huonghuy/High-Altitude-Monkey/SRC/Monkey/monkey code works version 1.11.txt

/////////// SOFTWARE VERSION NUMBER ///////////////////////////
// Ver 0.1M, 8/11/19
// Ver 0.2M, 8/14/19 adjusting communication from Serial2
// Ver 0.3MM  8/15/19 added Process_MONKEYMOVE
// Ver 0.4MM  8/16/19 got command parser to work from IDE
// Ver 0.5MM  8/19/19 ADDING HOME ROUTINE FOR SERVOS             
// Ver 0.6MM, 8/21/19 Intergrated serial communication between USIP and Monkey Board
// Ver 0.7MM, 8/22/19 Implemented monkey reply back top USIP board
// Ver 0.8MM, 8/23/19 Completed Monkey Touchdown move & monkey default position commands.
// Ver 0.9MM, 9/10/19 Works with Radio APRS
// Ver 0.91MM 9/26/19 Added monkey video commands
// Ver 0.92MM 9/26/19 Fixed string values for battey voltage, inside temp & xmtr temp, added IDE comm setup comments
// Ver 0.93MM 10/03/19 Added get_battery_voltage, get_inside_temp, get_tramsmitter_temp routines.
// Ver 0.94MM 10/03/19 Added sent get_battery_voltage, get_inside_temp, get_tramsmitter_temp to USIP board, and video on and off.
// Ver 0.95MM 10/07/19 I2C transmission to video.  Set I2CVIDEOADDR to the I2C address of the video
// Ver 0.96MM 10/13/19 Set voltage devide by value for battery.  
// Ver 0.97MM 10/13/19 Optimize Monkey Movements for Brown Monkey
// Ver 0.98MM 10/15/19 I2C works for Monkey and for potentiometer.
// Ver 0.99MM 10/15/19 Reads actual battery voltage, inside and Transmitter Temperature & MONKEY 17.
// Ver 1.0MM 10/17/19 Final chits-n-chatz before flight.
// Ver 1.1MM 10/17/19 Added stablize_monkey_slowly(); 
// Ver 1.11MM 10/18/19 Added slowed monkey even more.
//
// don't forget to adjust the #define VERSION below! 
// 
// USIP Copyright 2019 University of Bridgeport, Discovery Museum Bridgeport, CT, NASA, CT Space Grant Consortium.
// All rights reserved.
///////////////////////////////////////////////////////////////
#define VERSION "1.11MM" 

#include <Adafruit_DS3502.h>            // I2C digital potentiometer library
#include <Adafruit_PWMServoDriver.h>    //Download from Github
#include <Wire.h>                       //Included into Arduino library

// I2C section
#include <Adafruit_DS3502.h>            // I2C digital potentiometer library
Adafruit_DS3502 ds3502 = Adafruit_DS3502();
#define WIPER_pin A3

//Libraries Needed
//Adafruit busio

//Declarations
Adafruit_PWMServoDriver pwm = Adafruit_PWMServoDriver();

#define SERVOMIN 150 // min pulse lenghth count
#define SERVOMAX 600 // max pulse lenghth count

uint8_t servo1neck = 0;

int pos=0;
float fpos = 0.0;
int pos2=300;

int right=0;
int right2=300;
int right3=-60;

int left=0;
int left2=0;
int left3=0;

int ledpin = 13; // Led to blink
int x;
int MKRCV_pin = 16;
int MKXMT_pin = 17;

///////////////////// Tan Monkey Home Positions/////////////////////
int botHead0 = 300;
int topHead1 = 350;
int rightShoulder2 = 275;
int rightElbow3 = 400;
int leftShoulder4 = 400;
int leftElbow5 = 125;

int elbowRange = 50;

int xv;
float wiper_read = 0.0;
uint8_t wiper_value = 0;
int i=0;

///////////////////// New section///////////////////////////
String MonkeyCmd_str ="";   //will hold the command recieved from the USIP or IDE
String MONKEYMOVE_flg = ""; // what used for?
boolean MonkeyFlag= false; // when true used to call Monkey move routine in loop
boolean validcmd_flg = false;
String inStr0 ="";
String inStr2 ="";
boolean stablize_monkey_flg = false; // used to determine when to stabilize the monkey
unsigned long tee;

String Xavier="";
String Xavier2="";
String line="";

String thisStringIT = "";
String thisStringVB = "";;
String thisStringXT = "";

boolean string0Complete = false;  // whether the inStr0 is complete from the IDE Serial input routine
boolean string2Complete = false;  // whether the inStr0 is complete from the IDE Serial input routine
boolean I2Cpot = false;           // used at being of I2C return value to see if it began

#define MK1 "MONKEY"
#define MK01 "MONKEY 01"

int monkey_cmd_nbr = 0;  // used to parse monkey commands for video commands
int video_level = 0; // used to hold calculated video command number

// Battery Voltage defines
int Vbat = 0;    // battery voltage read
const float DivideByCircuit = 3.515; // divide by circuit factor this is the corrected value
int BatteryVoltagePin = A2; // Battery voltage connected to analog pin 2, outside leads to ground and +5V
int BatRead1  = 0;           // 1st value read of battery
float BatV1   = 0.0;         // variable to store the 1st value read
int BatRead2  = 0;           // 2nd value read of battery
float BatV2   = 0.0;         // variable to store the 1st value read
int BatRead3  = 0;           // 3rd value read of battery
float BatV3   = 0.0;         // variable to store the 1st value read
float BatSum  = 0.0;         // Battery Sum voltage used to calculate arithmetic mean
float BatMean = 0.0;         // arithmetic mean of battery voltage
int TenTimes  = 0;           // This is the voltage multiplied by 10 and then made into an integer.

// Inside Temperature defines
int InsideTempPin = A0; // Inside Temp sensor is connected to analog pin 0.
int InsideT = 0;   // Inside temp integer read
float TRaw = 0;    // raw temperature read
float TempK = 0.0; // is raw temperature converted to degrees Kelvin
float TempC = 0.0; //is Temperature Degrees Centigrade

// Transmitter Temperature defines
int XmtrTempPin = A1; // Inside Temp sensor is connected to analog pin A1.
int XmtrT = 0;   // transmitter temp Integer read
float XTRaw  = 0.0; //analogRead(XmtrTempPin);      // read transmitter temperature
float XTempK = 0.0; // = (XTRaw/2.046);
float XTempC = 0.0; // = XTempK - 273.15;
int xmtr_temp = 0; //  = (int) XTempC;

// Video Defines
// video ON/OFF is pin 22
#define VIDEO_pin 22  
#define I2CVIDEOADDR 51 // video device I2C address 50 hex write = 50, read = 51
int vid_status = 0;// this is the value returned by video_on() 1 = video is here, -1 = error.

////////////////////////////////////////////////////////////

void setup() {
  // setup code here, runs once:

  pinMode(ledpin, OUTPUT);
  pinMode(MKRCV_pin, INPUT);
  pinMode(MKXMT_pin, OUTPUT);
  pinMode(VIDEO_pin, OUTPUT); // video on off
  pinMode(WIPER_pin, INPUT); // wiper pin
  
  // initialize serial: 
  // Blink LED that we are up and running
  for (x=0; x<5; x++)  {
    digitalWrite(ledpin,HIGH);
    delay(100);
    digitalWrite(ledpin,LOW);
    delay(100);
  }
// IMPORTANT for IDE Communications, this configuration is important
// Autoscroll is checked
// Show Timestamp is unchecked
// first pull down is set to NEWLINE
// Baud pull down is set to whatever you set "Serial.begin" to in the statement below, in this case 9600
// Clear Output is not a settable button, It clears the output screen 
Serial.begin(9600);
Serial2.begin(9600);//Monkey cpu
//Serial.print("2 Channel servo test");
//Serial.println("");
Serial.print("USIP Monkey ");
Serial.println (VERSION); 
///////////////
//  Serial.println("Adafruit DS3502 Test");
//  Wire.begin();
//
//  if (!ds3502.begin(28)) {
//    Serial.println("Couldn't find DS3502 chip");
//    while (1);
//  }
//  Serial.println("Found DS3502 chip");
//  //////////
pwm.begin();
pwm.setPWMFreq(60);  //Analog servos run at ~60 Hz updates

// I2C bus set up
Wire.begin(); // join i2c bus (address optional for master)

I2Cpot = (ds3502.begin(0x28,&Wire));
  if (I2Cpot){
   Serial.println ("Found Pot");
 }
 else {
  Serial.print ("I couldn't find the I2C video pot! ");
  Serial.println ("MONKEY 17");
  Serial2.println("MONKEY 17");
 }

//monkey_rest(); // bring monkey to default positions AT THE START 
stablize_slowly();
} // end of setup

//////////////////////////////////////// LOOP /////////////////////////////////////////////////////
void loop() {      // Main code here, runs repeatedly

if (MonkeyFlag == true) {
  Process_MONKEYMOVE(MonkeyCmd_str);
  MonkeyCmd_str = ""; 
  MonkeyFlag = false;
}

//servohead_no_nod();
//servohead_yes_nod();
//servohead2(); //head half scan
//scanhead(); //Full scan
//right_arm2(); // Thumbs up
//left_arm (); // Wave
//monkey_chest();// Chest pound

/////not needed:////////
//head_scratch();
//monkey_reset();
//autopilot cycle();
} 

/////////////////////////////////////////////////////// Selecting a Monkey Command ////////////////////////////////////////////////////

void Process_MONKEYMOVE(String MonkCMDStr){
  validcmd_flg = false;
  stablize_monkey_flg = false;
    Serial.println(" ");
    Serial.print("ENTERED MONKEY MOVE/video set AND MonkCMDStr is: ");
    Serial.println(MonkCMDStr);

// Is it stablize?
if (MonkCMDStr.equals("MONKEY 00")){
    Serial.println("Command equals MONKEY 00 - Setting Monkey to default positions");
    // set any flags
    // call Monkey Motions
       stablize_slowly(); // bring monkey to default positions
  
    // send MONKEY 11 (done) to USIP
    Serial.print("MONKEY 11 (done) Signal");
    Serial2.println("MONKEY 11");
    validcmd_flg = true;
}
   
// Is it Head Nod Yes?
if (MonkCMDStr.equals("MONKEY 01")){
   Serial.println("Command equals MONKEY 01");
    // set any flags
    // call Head Nod Yes
   servohead_yes_nod();
    Serial.println("RETURNED FROM yes_nod()MONKEY01");    
    monkey_rest(); // bring monkey to default positions
    
    // send MONKEY 11 (done) to USIP 
    Serial.print("MONKEY 11 (done) Signal");
    Serial2.println("MONKEY 11");
    stablize_monkey_flg = true;
    validcmd_flg = true;
}

// Is it Head Nod No?
if (MonkCMDStr.equals("MONKEY 02")){
   Serial.println("Command equals MONKEY 02");
    // set any flags
    // call Head Nod No
  //    servohead_no_nod();
 servohead_no_nod();
 Serial.println("RETURNED FROM no_nod()MONKEY02");   
    
 monkey_rest(); // bring monkey to default positions

 // send MONKEY 11 (done) to USIP 
    Serial.print("MONKEY 11 (done) Signal");
    Serial2.println("MONKEY 11");
      validcmd_flg = true;
      stablize_monkey_flg = true;
}

// Is it Right Arm Thumbs Up?
if (MonkCMDStr.equals("MONKEY 03")){
    Serial.println("Command equals MONKEY 03");
    // set any flags
    // call Right Arm Thumbs Up
    right_arm2();
 Serial.println("RETURNED FROM right_arm2()MONKEY03"); 
    
    // send MONKEY 11 (done) to USIP 
      //monkey_rest();zzzz // bring monkey to default positions 
    Serial.print("MONKEY 11 (done) Signal");
    Serial2.println("MONKEY 11");
    validcmd_flg = true;
      stablize_monkey_flg = true;
}

// Is it Scan Head?
if (MonkCMDStr.equals("MONKEY 04")){
    Serial.println("Command equals MONKEY 04");
    // set any flags
    // call Scan Head
    scanhead();
     Serial.println("RETURNED FROM scan_head()MONKEY04"); 
    // send MONKEY 11 (done) to USIP
      monkey_rest(); // bring monkey to default positions
    Serial.print("MONKEY 11 (done) Signal");
  Serial2.println("MONKEY 11");
    validcmd_flg = true;
      stablize_monkey_flg = true;
}
// Is it Left Hand Wave?
if (MonkCMDStr.equals("MONKEY 05")){
    Serial.println("RETURNED FROM left_hand_wave()MONKEY05"); 
    // set any flags
    // call Left Hand Wave
    left_arm ();
    // send MONKEY 11 (done) to USIP
      monkey_rest(); // bring monkey to default positions
    Serial.print("MONKEY 11 (done) Signal");
    Serial2.println("MONKEY 11");
    validcmd_flg = true;
      stablize_monkey_flg = true;
}
// Is it a chest pound?
if (MonkCMDStr.equals("MONKEY 06")){
    Serial.println("RETURNED FROM chest_pound()MONKEY06"); 
    // set any flags
    // call Chest Pound
    monkey_chest();
    // send MONKEY 11 (done) to USIP
      //monkey_rest(); // bring monkey to default positions
      monkey_rest(); // bring monkey to default positions
    Serial.print("MONKEY 11 (done) Signal");
   Serial2.println("MONKEY 11");
   validcmd_flg = true;
     stablize_monkey_flg = true;
}
// Is it a touchdown signal?
if (MonkCMDStr.equals("MONKEY 07")){
    Serial.println("Command equals MONKEY 07");
    // set any flags
     monkey_touchdown(); // monkey to raise both arms up at once
     Serial.println("MONKEY 07 (touchdown) Signal");
     Serial2.println("MONKEY 11");
      //monkey_rest(); // bring monkey to default positions
      //monkey_rest(); // bring monkey to default positions
 //stablize_slowly(); // test
//    Serial.print("MONKEY 11 (done) Signal");
//    Serial2.println("MONKEY 11");
    validcmd_flg = true;
      stablize_monkey_flg = true;
}
// Is it all motions executed once?
if (MonkCMDStr.equals("MONKEY 08")){
    Serial.println("Command equals MONKEY 08");
    // set any flags
    // call Monkey Motions
      servohead_no_nod();
       servohead_yes_nod();
       scanhead(); //Full scan
       right_arm2(); // Thumbs up right arm
       left_arm (); // Wave left arm
       monkey_chest();  // Chest pound

       //monkey_rest(); // bring monkey to default positions
    // send MONKEY 11 (done) to USIP
    monkey_rest(); // bring monkey to default positions
    Serial.print("MONKEY 11 (done) Signal");
    Serial2.println("MONKEY 11");
    validcmd_flg = true;
      stablize_monkey_flg = true;
}
//I am Here
if (MonkCMDStr.equals("MONKEY 09")){
    Serial.println("Command equals MONKEY 09");
    Serial2.println("MONKEY 10");
        Serial.println("Sent MONKEY 10");
    validcmd_flg = true;
      stablize_monkey_flg = false;
}
// Is it a REQUEST FOR DATA?
if (MonkCMDStr.equals("MONKEY 12")){
    Serial.println("Command equals MONKEY 12");
    // Read appropriate Data
    // write data into appropriate variables
    // Vbat = battery voltage Integer
    // InsideT = Inside temp integer
    // XmtrT = transmitter temp Integer

      Vbat = get_bat_voltage(); // this routine reads the battery voltage
          Serial.println("battery voltage read");
          Serial.println(Vbat);
      InsideT = get_inside_temp(); // this routine reads the inside temperature
          Serial.println("Inside temperature read");
            Serial.println(InsideT);        
      XmtrT = get_xmtr_temp();   // this routine reads the transmitter temperature
          Serial.println("transmitter temperature read");
           Serial.println(XmtrT);     
//
//    tee = millis();
//Serial.print ("end time = ");
//Serial.println (tee);

    // send back MONKEY 13    
    // send data to USIP board via Serial 2
            Serial2.print("MONKEY 13 ");
    // send back Vbat InsideT and XmtrT
            Serial2.print(Vbat);
            Serial2.print(",");
            Serial2.print(InsideT);
            Serial2.print(",");
            Serial2.println(XmtrT);   
          // send monkey done
          // send MONKEY 11 (done) to USIP
          // Serial.print("MONKEY 11 (done) Signal");
         //  Serial2.println("MONKEY 11");
  
    validcmd_flg = true;
      stablize_monkey_flg = false;
}

// Is it a turn video OFF command?
if (MonkCMDStr.equals("MONKEY 20")){
    Serial.println("Command equals MONKEY 20");
    // set any flags
     Serial.println("MONKEY 20 turn video OFF");
    video_off(); // turn off video
    Serial.print("MONKEY 11 (done) Signal");
    Serial2.println("MONKEY 11");
    validcmd_flg = true;
}

// Is it a turn video ON command?
if (MonkCMDStr.equals("MONKEY 19")){
    Serial.println("Command equals MONKEY 19");
    // set any flags
     Serial.println("MONKEY 19 turn video ON");
     
    vid_status = video_on(); // turn on video  
    switch (vid_status) {
      case -1:
        // report to USIP that video is ON
            Serial.print("MONKEY 11 (done) Signal");
            Serial2.println("MONKEY 11");
         break;
      case 1:
        // report to USIP that video is NOT WORKING
        break;
      default:
        // report to USIP that video has returned a strange number
        break;
}
      
    vid_status = 0;// set to zero for next time
    validcmd_flg = true;
}

//check for a valid monkey video command 
// MonkCMDStr
monkey_cmd_nbr = MonkCMDStr.substring(7,9).toInt(); // monkey command now an interger number from 21 to 84

if ((monkey_cmd_nbr >= 21) && (monkey_cmd_nbr <= 84)){
// calculate the video level from monkey_cmd_nbr 
    Serial.println("calculating monkey video level number");
    video_level = (2*(monkey_cmd_nbr - 21));
    Serial.println("setting monkey video level number to:");
    Serial.println(video_level);
         
    set_video_level(video_level);
 
    Serial.print("set monkey video (done)");
    Serial.print("MONKEY 11 (done) Signal");
    Serial2.println("MONKEY 11");
    
    validcmd_flg = true; 
}  // end of if

/////////////////////////////////////////////////////////////////////// 
// etc do all the valid monkey xx commands
// then do invalid command
// is it invalid command?
//if (validcmd_flg==false && MonkCMDStr.equals("MONKEY 01") ){
 //  Serial.println("Invalid MONKEY ");

if( validcmd_flg == false){
 Serial.println("Invalid MONKEY Sent Dumped Command");
 Serial2.println("MONKEY 14"); //Dumped Command
 // dump the command it's no good
// send MONKEY 14 to USIP  I dumped it.
// transmit dump command
}

// No matter what, clear the MONKEYMOVE flag and all the rest of the flags etc.
MONKEYMOVE_flg = "";
MonkeyFlag= false;
MonkeyCmd_str = ""; 
monkey_cmd_nbr = 0; 
if (stablize_monkey_flg == true){
stablize_slowly();
}
stablize_monkey_flg = false; 
}

/////////////////////////////////////////////////////////////////////////////////////////////////////////////////////////////////////////////

/////////////Monkey Commands//////////////////

///////////////////////////////////////////was 10 10////3////////////////////////////////
void stablize(){
 Serial.println("Stablizing Monkey");
  for(pos = rightShoulder2; pos <= rightShoulder2 + 15; pos += 1){
    pwm.setPWM(2,0,pos);
    delay(3);
    pwm.setPWM(3,0,pos + 125);
    delay(3);
    pwm.setPWM(4,0,pos + 125);
    delay(3);
    pwm.setPWM(5,0,pos - 150);
    delay(3);
  }
  for(pos = rightShoulder2 + 15; pos >= rightShoulder2; pos -= 1){
    pwm.setPWM(2,0,pos);
    delay(3);
    pwm.setPWM(3,0,pos + 125);
    delay(3);
    pwm.setPWM(4,0,pos + 125);
    delay(3);
    pwm.setPWM(5,0,pos - 150);
    delay(3);
  }
  
}
///////////////////////////////////////////was 10 10////3////////////////////////////////
void stablize_slowly(){
 Serial.println("Slowly Stablizing Monkey");
  for(pos = rightShoulder2; pos <= rightShoulder2 + 15; pos += 1){
    pwm.setPWM(2,10,pos);
    delay(15);
    pwm.setPWM(3,10,pos + 125);
    delay(15);
    pwm.setPWM(4,10,pos + 125);
    delay(15);
    pwm.setPWM(5,10,pos - 150);
    delay(15);
  }
  for(pos = rightShoulder2 + 15; pos >= rightShoulder2; pos -= 1){
    pwm.setPWM(2,10,pos);
    delay(15);
    pwm.setPWM(3,10,pos + 125);
    delay(15);
    pwm.setPWM(4,10,pos + 125);
    delay(15);
    pwm.setPWM(5,10,pos - 150);
    delay(15);
  }
  servohead_no_nod_slowly();
}

/////////////////////////////////////////////////////////////

void servohead_yes_nod() {
//Servo1 left and right motion
Serial.println("Entered servohead_yes_nod()MONKEY 01");
for (pos = topHead1; pos <= topHead1 + 150; pos += 2) { // goes from 0 degrees to 180 degrees
  //Range = 150
    // in steps of 1 degree

    pwm.setPWM(0,0,botHead0); //start bottom servo head at middle position
    delay(2);

    pwm.setPWM(1,0,pos); //move top servo head down in increments
    delay(5);

 }

//for (pos = 400; pos >= 300; pos -= 1) { 
  for (pos = topHead1 + 150; pos >= topHead1; pos -= 1) {

      pwm.setPWM(1,0,pos); //move top servo head up in increments
      delay(5);
  
  }// 1st round

//2nd round:

//for (pos = 300; pos <= 400; pos += 1) { // goes from 0 degrees to 180 degrees
//    // in steps of 1 degree
//
//    pwm.setPWM(0,0,300); //start bottom servo head at middle position
//    //pos2=SERVOMIN;
//    delay(2);
//   
//    pwm.setPWM(1,0,pos-150); //move top servo head down in increments
//      delay(2);
//
//  }
//
//for (pos = 400; pos >= 300; pos -= 1) { 
//
//
//      pwm.setPWM(1,0,pos-150); //move top servo head up in increments
//      delay(2);
//  
//}

} //end servohead_yes_nod

//////////////////////////////////////////////////////////////////////////////////////////////////////////

void servohead_no_nod() {
//Servo1 left and right motion
for (pos = botHead0; pos <= botHead0 + 90; pos += 1) { // goes from 0 degrees to 180 degrees
   //Range = 90
 pwm.setPWM(0,0,pos); //bottom servo head    
    delay(2);    
 pwm.setPWM(1,0,topHead1); //top servo head
      delay(5);
  }

for (pos = botHead0 + 90; pos >= botHead0 - 90; pos -= 1) { 
  pwm.setPWM(0,0,pos);
  delay(2); 
}  //1st round

//2nd round:

for (pos = botHead0 - 90; pos <= botHead0; pos += 1) { // goes from 0 degrees to 180 degrees  
 pwm.setPWM(0,0,pos); //bottom servo head
    //pos2=SERVOMIN;
    delay(2);
    pwm.setPWM(1,0,topHead1); //top servo head
      delay(5);
  }

for (pos = botHead0; pos <= botHead0 + 90; pos += 1) { // goes from 0 degrees to 180 degrees
   //Range = 90
 pwm.setPWM(0,0,pos); //bottom servo head
   delay(2);   
 pwm.setPWM(1,0,topHead1); //top servo head
      delay(5);
  }
for (pos = botHead0 + 90; pos >= botHead0 - 90; pos -= 1) { 
  pwm.setPWM(0,0,pos);
  delay(2);
}  //1st round

//2nd round:
for (pos = botHead0 - 90; pos <= botHead0; pos += 1) { // goes from 0 degrees to 180 degrees   
 pwm.setPWM(0,0,pos); //bottom servo head
    //pos2=SERVOMIN;
    delay(2);
    pwm.setPWM(1,0,topHead1); //top servo head
      delay(5);
  }
}//end of no nod

//////////////////////////////////////////////////////////////////////////////////////////////////////////

void left_arm (){
 
  for (left = leftShoulder4; left >= leftShoulder4 - 250; left -= 1) { // 1ft move up shoulder
    //Range == -250
   //if(left>100){
   pwm.setPWM(4,0,left);
   //pos2=300;
   delay(7);
   }

//hand wave 1st cycle:

for (left = leftElbow5; left <= leftElbow5 + elbowRange; left += 1) { // 2nd move right side arm 2 of 2
  //Range == +60
   //if(left>100){
   pwm.setPWM(5,0,left);
   //pos2=300;
   delay(5);
   }
for (left = leftElbow5 + elbowRange; left >= leftElbow5; left -= 1) { // 2nd move left side arm  1 of 2
   //if(left>100){
   pwm.setPWM(5,0,left);
   //pos2=300;
   delay(5);
   }

//hand wave 2nd cycle

/////////////////////// hand wave 1st cycle//////////////////////////////////////////////
for (left = leftElbow5; left <= leftElbow5 + elbowRange; left += 1) { // 2nd move right side arm 2 of 2
  //Range == +60
   //if(left>100){
   pwm.setPWM(5,0,left);
   //pos2=300;
   delay(5);
   }
for (left = leftElbow5 + elbowRange; left >= leftElbow5; left -= 1) { // 2nd move left side arm  1 of 2
   //if(left>100){
   pwm.setPWM(5,0,left);
   //pos2=300;
   delay(5);
   }

////////////////////////////////////

//////////Returning shoulder back to original position///////////////////////

  for (left = leftShoulder4 - 250; left <= leftShoulder4; left += 1) { // 3rd move down slowly shoulder
   //if(left>100){
   pwm.setPWM(4,0,left);
   //pos2=300;
   delay(7);
   }

}//end of left arm

/////////////////////////////////////////////////////////////////////////////////////////////////////////////

void servohead2(){      //Tilt,look down and reset
//Servo1 left and right motion
for (pos = botHead0; pos <= botHead0 + 100; pos += 1) { // goes from 0 degrees to 180 degrees
  //Range == +100
    // in steps of 1 degree

    pwm.setPWM(0,0,pos); //bottom servo head
    //pos2=SERVOMIN;
    delay(5);

    pwm.setPWM(1,0,pos-150); //top servo head RH
      delay(5);

  }

for (pos = botHead0 + 100; pos >= botHead0; pos -= 1) { 

  pwm.setPWM(0,0,pos);
  delay(15);

      pwm.setPWM(1,0,pos-150); //top servo head
      delay(5);
  
}

}//end of servohead2 

////////////////////////////////////////////////////////
void scanhead(){       //ACtually scanning the console
//Servo1 left and right motion
for (pos = botHead0; pos <= botHead0 + 100; pos += 1) { // goes from 0 degrees to 180 degrees
  //Range = +100
    // in steps of 1 degree
    // Head tilts down as it turns left

    pwm.setPWM(0,0,pos); //bottom servo head
    //pos2=SERVOMIN;
    delay(5);

    pwm.setPWM(1,0,pos+50); //top servo head
      delay(5);

  }

for (pos = botHead0 + 100; pos >= botHead0 - 100; pos -= 1) { 
  // Head locks angle of neck and looks right
  pwm.setPWM(0,0,pos);
  delay(3);

      //pwm.setPWM(1,0,pos-150); //top servo head
      //delay(5);
  
}
for (pos = botHead0 - 100; pos <= botHead0 + 100; pos += 1) { 
  // Head looks back left
  pwm.setPWM(0,0,pos);
  delay(3);

      //pwm.setPWM(1,0,pos-150); //top servo head
      //delay(5);
  
}
for (pos = botHead0 + 100; pos >= botHead0; pos -= 1) { 
  // Head returns to normal
  pwm.setPWM(0,0,pos);
  delay(3);

      pwm.setPWM(1,0,pos+50); //top servo head
      delay(5);
  
}

}///////////////////end of scan head

void right_arm2 (){   //Thumbs up action
  for (right = rightShoulder2; right <= rightShoulder2 + 200 ; right += 1) { // goes from 0 degrees to 180 degrees
    //Range = + 200
    pwm.setPWM(2,0,right); //right shoulder servo head
    delay(5);
    
  }

  for (right = rightElbow3; right >= rightElbow3 - 95; right -= 1) {
    //Range = -95
      pwm.setPWM(3,0,right); //right arm servo head
      delay(10); 
  }
  
  for (right = rightElbow3 - 95; right <= rightElbow3; right += 1) {
      pwm.setPWM(3,0,right); //right arm servo head
      delay(7); 
  }

  for (right = rightShoulder2 + 200; right >= rightShoulder2; right -= 1) { // goes from 180 degrees to 0 degrees
  
   pwm.setPWM(2,0,right);
   //pos2=300;
   delay(5);
   }

} //end right_arm

////////////////////////////////////////////////////////////////////////////////////////

void monkey_chest (){   //Monkey beating chest action
//Range = +170
  for (right = rightShoulder2; right <= rightShoulder2 + 170; right += 1) { // move up right shoulder
    pwm.setPWM(2,0,right); //right shoulder servo head
    delay(5);
    
  }

  ///>>>>>>>>>Right arm Movement>>>>>////////

for (left = leftShoulder4; left >= leftShoulder4 - 200; left -= 1) { // 1ft move up left shoulder
  //Range = -200
   //if(left>100){
   pwm.setPWM(4,0,left);
   //pos2=300;
   delay(7);
   }
///////////////////////////////// 

//Right forearm motion: 1st cycle

  for (right = rightElbow3; right >= rightElbow3 - 225; right -= 1) {
    //Range = - 225
      pwm.setPWM(3,0,right); //right arm servo head
      delay(1); 
  }
 
  for (right = rightElbow3 - 225; right <= rightElbow3; right += 1) {
      pwm.setPWM(3,0,right); //right arm servo head
      delay(1); 
 }

// left forearm motion: 1st cycle

for (left = leftElbow5; left <= leftElbow5 + 200; left += 1) { // 2nd move right side arm 2 of 2
  //Range = +200
   //if(left>100){
   pwm.setPWM(5,0,left);
   //pos2=300;
   delay(1);
   }
for (left = leftElbow5 + 200 ; left >= leftElbow5; left -= 1) { // 2nd move left side arm  1 of 2
   //if(left>100){
   pwm.setPWM(5,0,left);
   //pos2=300;
   delay(1);
   }

/////////////////////////////////////////////
//////// 2nd cycle of forearm chest movement

//Right forearm motion: 2nd motion

  for (right = rightElbow3; right >= rightElbow3 - 225; right -= 1) {
    //Range = - 225
      pwm.setPWM(3,0,right); //right arm servo head
      delay(1); 
  }
 
  for (right = rightElbow3 - 225; right <= rightElbow3; right += 1) {
      pwm.setPWM(3,0,right); //right arm servo head
      delay(1); 
 }

// left forearm motion: 2nd motion

for (left = leftElbow5; left <= leftElbow5 + 200; left += 1) { // 2nd move right side arm 2 of 2
  //Range = 200
   //if(left>100){
   pwm.setPWM(5,0,left);
   //pos2=300;
   delay(1);
   }
for (left = leftElbow5 + 200 ; left >= leftElbow5; left -= 1) { // 2nd move left side arm  1 of 2
   //if(left>100){
   pwm.setPWM(5,0,left);
   //pos2=300;
   delay(1);
   }

////////

  for (right = rightShoulder2 + 170; right >= rightShoulder2; right -= 1) { // bring left shoulder back to original position
  
   pwm.setPWM(2,0,right);
   //pos2=300;
   delay(5);
   }

for (left = leftShoulder4 - 200; left <= leftShoulder4; left += 1) { // bring left shoulder back to original position
   pwm.setPWM(4,0,left);
   delay(3);
   }

} //end chest movement

///////////////////////////////////////////////////////////////////////

//Communication section - taking in initial commands

// --> one from keyboard (IDE - Serial.print() )
/* SerialEvent occurs whenever a new data comes in the
   hardware serial RX.  This routine is run between each
   time loop() runs, so using delay inside loop can delay
   response.  Multiple bytes of data may be available.
*/
void serialEvent() {
   while (Serial.available()) {
                 // get the new byte:
                 
// Serial.print("GETTING NEW BYTE\n");  

                 char inChar0 = (char)Serial.read();
                 // add it to the inputString:
                 
                   Serial.print("Just read character: ");
                    Serial.print(inChar0,HEX);
                      Serial.print(" ");
                    Serial.print(inChar0);
                   Serial.println();
                   
                 inStr0 += inChar0;
                 //Serial.print("Test String : ");
                  Serial.println(inStr0);
                  
                  if (inStr0.length() > 11) {
                    inStr0 = "";
                  }
                  
                 // if the incoming character is a newline, set a flag
                 // so the main loop can do something about it:
                 if (inChar0 == '\n') {
                    string0Complete = true;

                    ////
                    Serial.println("Temp String is: " + inStr0);
                    Serial.print("It is this many characters long: ");
                    Serial.println(inStr0.length());

                    Xavier = inStr0.substring(0,9);

                    Serial.println("The substring is: " + Xavier);

                 //   line = "\n";
                //    Xavier.concat(line);

                    MonkeyCmd_str = Xavier;

                //    Serial.print( MonkeyCmd_str,HEX);

                 //   MonkeyCmd_str = inStr0; // store completed string0 into monkey Command string
                    
                    ////troubleshooting//////////
                    Serial.print(MonkeyCmd_str);
                    
                    ////////////////
                    
                    inStr0 = "";
                    MonkeyFlag= true; // Signal loop that we are ready to process monkey command
                    Serial.println("set MonkeyFlag = True");
                 }
               }
/*//// TESTING////////////////////////////////////////////////////////////
//// TESTING////////////////////////////////////////////////////////////
//// TESTING////////////////////////////////////////////////////////////
/////////////////////////////////////
          if (MonkeyFlag == true) {
            Serial.println("MonkeyFlag is True");
            }  
          else{
            Serial.println("MonkeyFlag is not True");
            } 

          ///////////////////////*/
       //    MonkeyFlag= true;
       //   MonkeyCmd_str = "MONKEY 12";   
//// TESTING////////////////////////////////////////////////////////////           

          }// end of serialEvent() // must leave this line after testing
//////////////////////////////////////////////////////////////////////////////////////////////
void serialEvent2() {
   while (Serial2.available()) {
                 // get the new byte:
                 
// Serial.print("GETTING NEW BYTE\n");  

                 char inChar2 = (char)Serial2.read();
                 // add it to the inputString:
                 
                   Serial.print("Just read character: ");
                    Serial.print(inChar2,HEX);
                      Serial.print(" ");
                    Serial.print(inChar2);
                   Serial.println();
                   
                 inStr2 += inChar2;
                 
                  if (inStr2.length() > 11) {
                    inStr2 = "";
                  }
                 // if the incoming character is a newline, set a flag
                 // so the main loop can do something about it:
                 if (inChar2 == '\n') {
                    string2Complete = true;

                    ////
                    Serial.println("Temp String is: " + inStr2);
                    Serial.print("It is this many characters long: ");
                    Serial.println(inStr2.length());

                    Xavier2 = inStr2.substring(0,9);

                    Serial.println("The substring is: " + Xavier2);

                 //   line = "\n";
                //    Xavier.concat(line);

                    MonkeyCmd_str = Xavier2;

                //    Serial.print( MonkeyCmd_str,HEX);

                 //   MonkeyCmd_str = inStr0; // store completed string0 into monkey Command string
                    
                    ////troubleshooting//////////
                    Serial.print(MonkeyCmd_str);
                    
                    ////////////////
                    
                    inStr2 = "";
                    MonkeyFlag= true; // Signal loop that we are ready to process monkey command
                 }
               }

             }

//////////////////////////////////////////////////////////////////////////
// Head Servo Left & Right
void bottom_head_servo_go_home(){  //pin 0 - on servo board                  
Serial.println("Entered bottom_head_servo_go_home(): Moving top servo to home ");
   pwm.setPWM(0,0,300); // 300 is facing forward. Greater moves right, less moves left
  
}
/////////////////////////////////////////////////////////////////////////////////
// Head Servo Up & Down
void top_head_servo_go_home(){  //pin 1 - on servo board
Serial.println("Entered top_head_servo_go_home(): Moving bottom servo to home ");
   pwm.setPWM(1,0,220);  // greater is up, less is down
   
}

/////////////////////////////////////////////////////////////////////////////////
// Brings Right shoulder down
void right_shoulder_go_home(){  //pin 2 - on servo board 
Serial.println("Entered right_shoulder_go_home() ");
 pwm.setPWM(2,0,275); // greater is up, less is down

}

/////////////////////////////////////////////////////////////////////////////////
// brings right elbow outwards
void right_elbow_go_home(){  //pin 3 - on servo board 
  Serial.println("Entered right_elbow_go_home() ");
   pwm.setPWM(3,0,200); // less is inward
   
}

/////////////////////////////////////////////////////////////////////////////////
// Brings Left shoulder down
void left_shoulder_go_home(){  //pin 4 - on servo board 
  pwm.setPWM(4,0,400); // less is up, greater is down
  
Serial.println("Entered left_shoulder_go_home() ");
}

/////////////////////////////////////////////////////////////////////////////////
// brings left elbow outwards
void left_elbow_go_home(){  //pin 5 - on servo board 
  Serial.println("Entered left_elbow_go_home() ");
 pwm.setPWM(5,0,leftElbow5); // greater is outwards
 
}

/////////////////////////////////////////////////////////////////////////////////
// Monkey Touchdown
void monkey_touchdown(){  //pin 5 - on servo board 
  Serial.println("Entered monkey touch down() ");

  touchdown_head_bottom_servo_();
  touchdown_head_top_servo_();
  touchdown_right_elbow_go_home();
  left_elbow_go_home(); 
  touchdown_left_arm_go_up();  
  right_arm_go_up();
  stablize_slowly();

  }
  /////////////////////////////////////////////////////////////////////////////////
// MONKEY LEFT ARM GO UP
// assumes left elbow in home position
void left_arm_go_up(){  
    for (left = leftShoulder4; left >= leftShoulder4 - 400; left -= 1) { // 1ft move up shoulder
      //Range = -400
   //if(left>100){
   pwm.setPWM(4,0,left);
   //pos2=300;
   delay(7);
   }
  Serial.println("Entered monkey left arm go up() ");

  }

  ///////////////////////////////////////////////////////////////////////////////////
  void touchdown_left_arm_go_up(){  
    for (left = leftShoulder4; left >= leftShoulder4 - 300; left -= 1) { // 1ft move up shoulder  
      //Range = -300
   //if(left>100){
   pwm.setPWM(4,0,left);
   //pos2=300;
   delay(7);
   }
  Serial.println("Entered monkey touchdown left arm go up() ");

  }
  /////////////////////////////////////////////////////////////////////////////////
// MONKEY RIGHT ARM GO UP
// assumes right elbow in home position
void right_arm_go_up(){  
  Serial.println("Entered monkey right arm go up() ");
  
  for (right = rightShoulder2; right <= rightShoulder2 + 710; right += 1) { // move up right shoulder  //690
    //Range = + 710
    pwm.setPWM(2,0,right); //right shoulder servo head
    
    delay(5);
    
  }
  }
/////////////////////////////////////////////////////////////////////////////////
// brings right elbow outwards for touchdown
void touchdown_right_elbow_go_home(){  //pin 3 - on servo board 
   Serial.println("Entered touchdown_right_elbow_go_home() ");
   pwm.setPWM(3,0,rightElbow3); // 390-400 LOOKS GOOD
}

//////////////////////////////////////////////////////////////////////////////////////
void touchdown_head_bottom_servo_(){ //MOVES HEAD TO THE MIDDLE POSITION (HORIZONTALLY)
  Serial.println("Entered touchdown_head_bottom_servo_() ");
  pwm.setPWM(0,0,botHead0); // 390-400 LOOKS GOOD
  
}
////////////////////////////////////////////////////////////////////////////////////////

//////////////////////////////////////////////////////////////////////////////////////
void touchdown_head_top_servo_(){   ////MOVES HEAD DOWN A LITTLE (VERTICALLY)
  Serial.println("Entered touchdown_head_top_servo_() ");
   pwm.setPWM(1,0,topHead1); // 390-400 LOOKS GOOD
  
}
////////////////////////////////////////////////////////////////////////////////////////

void monkey_rest(){     // Runs when "Monkey 00" comand is called
    // call Monkey Motions
//  bottom_head_servo_go_home();
//  top_head_servo_go_home();  
//  right_shoulder_go_home();
//  left_shoulder_go_home(); 
//  left_elbow_go_home();
//  right_elbow_go_home(); 
//  
}

///////////////////////////////////////////////////////////////////////////////////////
//this issues the command to turn the video OFF

void video_off(){
  Serial.println("Entered video_off()");
      digitalWrite(VIDEO_pin, LOW);
}

///////////////////////////////////////////////////////////////////////////////////////
//this issues the command to turn the video ON
// This should then test to see if the video is operating
// if yes then set the level to 
// if no, then report that the video is "not on"
// make this a function which returns 1 = good, -1 = bad not turned on

int video_on(){
  int video_status;
    Serial.println("Entered video_on()");
    digitalWrite(VIDEO_pin, HIGH);
    set_video_level(31);  // set video to mid level of 31
    delay (100);
    // query the video R U there?

return (video_status);
}

///////////////// Set Video Level ////////////////////////////////////////////////
//I2CVIDEOADDR  IS #def'd at top and is the video device I2C address
//
void set_video_level(int video_level){
  
      Serial.println("Entered set_video_level()");
      //Wire.write(video_level);
      ds3502.setWiper(video_level); 

      //read the pin 
      wiper_read = analogRead(WIPER_pin);
      Serial.print ("wiper read value from pin =  ");
      Serial.println (wiper_read);
      
      Serial.println("Reading the wiper");
      wiper_value = ds3502.getWiper();
      Serial.print ("wiper read value from get.Wiper() =  ");
      Serial.println (wiper_value);
 
/* test software

 for (i=21; i<84; i++){
 video_level = i;
      //Wire.write(video_level);
 ds3502.setWiper(i); 
 wiper_read = analogRead(WIPER_pin);
 Serial.print ("i =  ");
 Serial.print (i);
 Serial.print (" wiper read value from pin =  ");
 Serial.print (wiper_read);
 Serial.print("  ");     
 Serial.print("Reading the wiper"); 
 wiper_value = ds3502.getWiper();
 Serial.print ("wiper read value from get.Wiper() =  ");
 Serial.println (wiper_value);
 }
 */
      
}

/////////////////////////////// this routine reads the battery voltage ///////////////////////////////////////////////////
int get_bat_voltage(){
// battery voltage
// voltage = 0.0 - 5.0v
// ADC = 0.0 - 1023
// Battery voltage range is 0.0 - 16.8 volts
// There will be a divide by 4 circuit between the pin and the sensor
// Actual battery voltage = (calculated voltage read) * (Divide by circuit = 4) 
//       y      =  m       *  X            + b
// voltage read = (5/1023) * (ADC reading) + 0
// Take 3 readings 1/10 second apart.
// convert the readings to voltage
// convert the voltages to battery voltages via DivideByCircuit factor
// sum the voltages then take arithmetic mean by dividing by 3
// multiply by 10 as we are sending the voltage and the first decimal digit
// then convert to integer and send the integer of 10 times the voltage
// Battery Voltage defines
// int Vbat = 0;    // battery voltage read
// const float DivideByCircuit = 3.6; // divide by circuit factor
// int BatteryVoltagePin = A2;  // Battery voltage connected to analog pin 2, outside leads to ground and +5V
// int BatRead1  = 0;           // 1st value read of battery
// float BatV1   = 0.0;         // variable to store the 1st value read
// int BatRead2  = 0;           // 2nd value read of battery
// float BatV2   = 0.0;         // variable to store the 1st value read
// int BatRead3  = 0;           // 3rd value read of battery
// float BatV3   = 0.0;         // variable to store the 1st value read
// float BatSum  = 0.0;         // Battery Sum voltage used to calculate arithmetic mean
// float BatMean = 0.0;         // arithmetic mean of battery voltage
// int TenTimes  = 0;           // This is the voltage multiplied by 10 and then made into an integer.
//
//tee = millis();
//Serial.print ("time before read = ");
//Serial.println (tee);

BatRead1 = analogRead(BatteryVoltagePin);  // read the input pin for the first time
delay(100); // delay 0.1 seconds

BatRead2 = analogRead(BatteryVoltagePin);  // read the input pin for the 2nd time
delay(100); // delay 0.1 seconds

BatRead3 = analogRead(BatteryVoltagePin);  // read the input pin for the 3rd time
//Serial.println(BatRead1);
//Serial.println(BatRead2);
//Serial.println(BatRead3);

// calculate the voltages from the ADC  read values
BatV1 = (((float)BatRead1)/204.6) * DivideByCircuit;

BatV2 = (((float)BatRead2)/204.6) * DivideByCircuit;

BatV3 = (((float)BatRead3)/204.6) * DivideByCircuit;
//Serial.println(BatV1);
//Serial.println(BatV2);
//Serial.println(BatV3);
BatSum = BatV1+BatV2+BatV3;
BatMean = (BatSum/3.0);
TenTimes = (int)(BatMean * 10.0);

return (TenTimes);

}

//////////////////////////////////////////////////////////////////////////////
//////////////////////////// this routine reads the inside temperature //////////////////////////////////////////////////////
// Read appropriate Data
// Inside Temp is read on pin A0
// voltage = 0.0 - 5.0v
// ADC = 0.0 - 1023
// Temperature is 0 - 500 K (degrees Kelvin)
// We should send USIP T degrees C
// Actual temp = (calculated voltage read)
//       y      =  m       *  X            + b
// temp read = (500/1023) * (ADC reading) + 0
// convert the readings to temp
// int InsideTempPin = A0; // Inside Temp sensor is connected to analog pin 0.
// int InsideT = 0; // Inside temp integer read
// float TRaw raw temperature read
// float TempK is raw temperature converted to degrees Kelvin
// float TempC is Temperature Degrees Centigrade

 int get_inside_temp(){
      int T_inside = 0;
      TRaw  = analogRead(InsideTempPin);  // read the inside temp 
      Serial.println(TRaw);
      /// TEST
      /// TRaw = 1023;
       
      TempK = (TRaw/2.046);
      TempC = TempK - 273.15;
      T_inside = (int) TempC;
 return (T_inside);
      }

//////////////////////////////////////////////////////////////////////////////
/////////////////////////////// this routine reads the Transmitter Temp ///////////////////////////////////////////////////
// Xmtr Temp is read on pin A1
// voltage = 0.0 - 5.0v
// ADC = 0.0 - 1023
// Temperature is 0 - 500 K (degrees Kelvin)
// We should send USIP T degrees C
// Actual temp = (calculated voltage read)
//       y      =  m       *  X            + b
// temp read = (500/1023) * (ADC reading) + 0
// convert the readings to temp
// int XmtrTempPin = A1; // Inside Temp sensor is connected to analog pin A1.
// int XmtrT = 0;   // transmitter temp Integer read
// float XTRaw  = 0.0; //analogRead(XmtrTempPin);      // read transmitter temperature
// float XTempK = 0.0; // = (XTRaw/2.046);
// float XTempC = 0.0; // = XTempK - 273.15;
// int xmtr_temp = 0; //  = (int) XTempC;

 int get_xmtr_temp(){   // this routine reads the transmitter temperature
      int xmtr_temp = 0;
      XTRaw  = analogRead(XmtrTempPin);      // read transmitter temperature
      // TEST
     // XTRaw = 1024/2;
      Serial.println(XTRaw);
      XTempK = (XTRaw/2.046);
      XTempC = XTempK - 273.15;
      xmtr_temp = (int) XTempC;
 return (xmtr_temp);
      }
//////////////////////////////////////////////////////////////////////////////
/////////////////////////////HEAD NOD SLOWLY/////////////////////////////////////////////////////////////////////////////
///////////////////// Tan Monkey Home Positions/////////////////////
//int botHead0 = 300;
//int topHead1 = 350;
//int rightShoulder2 = 275;
//int rightElbow3 = 400;
//int leftShoulder4 = 400;
//int leftElbow5 = 125;
//#define SERVOMIN 150 // min pulse lenghth count
//#define SERVOMAX 600 // max pulse lenghth count
//uint8_t servo1neck = 0;
//int pos=0;
//float fpos = 0.0;
//int pos2=300;
//int right=0;
//int right2=300;
//int right3=-60;
//int left=0;
//int left2=0;
//int left3=0;
//int elbowRange = 50;

void servohead_no_nod_slowly() {
//Servo1 left and right motion

 pwm.setPWM(1,0,topHead1); //top servo head UP/DOWN
      delay(5);
      
for (pos = botHead0; pos <= botHead0 + 20; pos += 1) { // goes from 0 degrees to 180 degrees
   //Range = 20
    pwm.setPWM(0,0,pos); //bottom servo head   
    delay(10);  

  }

for (pos = botHead0 + 20; pos >= botHead0 - 20; pos -= 1) { 
  pwm.setPWM(0,0,pos); //bottom servo head 
  delay(10); 
}  //1st round

//2nd round:

//
for (pos = botHead0 - 20; pos <= botHead0; pos += 1) { // goes from 0 degrees to 9? degrees  
 pwm.setPWM(0,0,pos); //bottom servo head
    //pos2=SERVOMIN;
    delay(10);
    pwm.setPWM(1,0,topHead1); //top servo head
      delay(5);
  }

for (pos = botHead0; pos <= botHead0 + 20; pos += 1) { // goes from 0 degrees to 180 degrees
   //Range = 90
 pwm.setPWM(0,0,pos); //bottom servo head
   delay(30);   
 pwm.setPWM(1,0,topHead1); //top servo head
      delay(5);
  }
for (pos = botHead0 + 20; pos >= botHead0 - 20; pos -= 1) { 
  pwm.setPWM(0,0,pos);
  delay(30);
}  //1st round

//2nd round:
for (pos = botHead0 - 20; pos <= botHead0; pos += 1) { // goes from 0 degrees to 180 degrees   
 pwm.setPWM(0,0,pos); //bottom servo head
    //pos2=SERVOMIN;
    delay(30);
    pwm.setPWM(1,0,topHead1); //top servo head
      delay(5);
  }
  
}//end of no nod slowly
