huonghuy/High-Altitude-Monkey/Backup Files/USIP/Software/monkey code works version 097.txt

/////////// SOFTWARE VERSION NUMBER ///////////////////////////
// Ver 0.1M, 8/11/19
// Ver 0.2M, 8/14/19 adjusting communication from Serial2
// Ver 0.3MM  8/15/19 added Process_MONKEYMOVE
// Ver 0.4MM  8/16/19 got command parser to work from IDE
// Ver 0.5MM  8/19/19 ADDING HOME ROUTINE FOR SERVOS             
// Ver 0.6MM, 8/21/19 Intergrated serial communication between USIP and Monkey Board
// Ver 0.7MM, 8/22/19 Implemented monkey reply back top USIP board
// Ver 0.8MM, 8/23/19 Completed Monkey Touchdown move & monkey default position commands.
// Ver 0.9MM, 9/10/19 Works with Radio APRS
// Ver 0.91MM 9/26/19 Added monkey video commands
// Ver 0.92MM 9/26/19 Fixed string values for battey voltage, inside temp & xmtr temp, added IDE comm setup comments
// Ver 0.93MM 10/03/19 Added get_battery_voltage, get_inside_temp, get_tramsmitter_temp routines.
// Ver 0.94MM 10/03/19 Added sent get_battery_voltage, get_inside_temp, get_tramsmitter_temp to USIP board, and video on and off.
// Ver 0.95MM 10/07/19 I2C transmission to video.  Set I2CVIDEOADDR to the I2C address of the video
// Ver 0.96MM 10/13/19 Set voltage devide by value for battery.  
// Ver 0.97MM 10/13/19 Optimize Monkey Movements for Brown Monkey
//
// don't forget to adjust the #define VERSION below! 
// 
// USIP Copyright 2019 University of Bridgeport, Discovery Museum Bridgeport, CT, NASA, CT Space Grant Consortium.
// All rights reserved.
///////////////////////////////////////////////////////////////
#define VERSION "0.97MM" 

#include <Adafruit_PWMServoDriver.h>    //Download from Github
#include <Wire.h>                       //Included into Arduino library
//Libraries Needed
//Adafruit busio

//Declarations
Adafruit_PWMServoDriver pwm = Adafruit_PWMServoDriver();

#define SERVOMIN 150 // min pulse lenghth count
#define SERVOMAX 600 // max pulse lenghth count

uint8_t servo1neck = 0;

int pos=0;
int pos2=300;

int right=0;
int right2=300;
int right3=-60;

int left=0;
int left2=0;
int left3=0;

int ledpin = 13; // Led to blink
int x;
int MKRCV_pin = 16;
int MKXMT_pin = 17;

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

int elbowRange = 50;

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

String Xavier="";
String Xavier2="";
String line="";

String thisStringIT = "";
String thisStringVB = "";;
String thisStringXT = "";

boolean string0Complete = false;  // whether the inStr0 is complete from the IDE Serial input routine
boolean string2Complete = false;  // whether the inStr0 is complete from the IDE Serial input routine
#define MK1 "MONKEY"
#define MK01 "MONKEY 01"

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

// Battery Voltage defines
int Vbat = 0;    // battery voltage read
const float DivideByCircuit = 3.6; // divide by circuit factor this is the corrected value
int BatteryVoltagePin = A2; // Battery voltage connected to analog pin 2, outside leads to ground and +5V
int BatRead1  = 0;           // 1st value read of battery
float BatV1   = 0.0;         // variable to store the 1st value read
int BatRead2  = 0;           // 2nd value read of battery
float BatV2   = 0.0;         // variable to store the 1st value read
int BatRead3  = 0;           // 3rd value read of battery
float BatV3   = 0.0;         // variable to store the 1st value read
float BatSum  = 0.0;         // Battery Sum voltage used to calculate arithmetic mean
float BatMean = 0.0;         // arithmetic mean of battery voltage
int TenTimes  = 0;           // This is the voltage multiplied by 10 and then made into an integer.

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

// Video Defines
// video ON/OFF is pin 22
#define VIDEO_pin 22  
#define I2CVIDEOADDR 50 // video device I2C address 50 hex write = 50, read = 51
int vid_status = 0;// this is the value returned by video_on() 1 = video is here, -1 = error.

////////////////////////////////////////////////////////////

void setup() {
  // setup code here, runs once:

  pinMode(ledpin, OUTPUT);
  pinMode(MKRCV_pin, INPUT);
  pinMode(MKXMT_pin, OUTPUT);
  pinMode(VIDEO_pin, OUTPUT); // video on off
  
  // initialize serial: 
  // Blink LED that we are up and running
  for (x=0; x<5; x++)  {
    digitalWrite(ledpin,HIGH);
    delay(100);
    digitalWrite(ledpin,LOW);
    delay(100);
  }
// IMPORTANT for IDE Communications, this configuration is important
// Autoscroll is checked
// Show Timestamp is unchecked
// first pull down is set to NEWLINE
// Baud pull down is set to whatever you set "Serial.begin" to in the statement below, in this case 9600
// Clear Output is not a settable button, It clears the output screen 
Serial.begin(9600);
Serial2.begin(9600);//Monkey cpu
//Serial.print("2 Channel servo test");
//Serial.println("");
Serial.print("USIP Monkey ");
Serial.println (VERSION); 

pwm.begin();
pwm.setPWMFreq(60);  //Analog servos run at ~60 Hz updates

// I2C bus set up
Wire.begin(); // join i2c bus (address optional for master)

monkey_rest(); // bring monkey to default positions AT THE START 
}

//////////////////////////////////////// LOOP /////////////////////////////////////////////////////
void loop() {      // Main code here, runs repeatedly

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

/////not needed:////////
//head_scratch();
//monkey_reset();
//autopilot cycle();
} 

/////////////////////////////////////////////////////// Selecting a Monkey Command ////////////////////////////////////////////////////

void Process_MONKEYMOVE(String MonkCMDStr){
  validcmd_flg = false;
    Serial.print("ENTERED MONKEY MOVE AND MonkCMDStr is: ");
    Serial.println(MonkCMDStr);

// Is it top head servo go home?
if (MonkCMDStr.equals("MONKEY 00")){
    Serial.println("Command equals MONKEY 00 - Setting Monkey to default positions");
    // set any flags
    // call Monkey Motions
       monkey_rest(); // bring monkey to default positions
  
    // send MONKEY 11 (done) to USIP
    Serial.print("MONKEY 11 (done) Signal");
    Serial2.println("MONKEY 11");
    validcmd_flg = true;
}
   
// Is it Head Nod Yes?
if (MonkCMDStr.equals("MONKEY 01")){
   Serial.println("Command equals MONKEY 01");
    // set any flags
    // call Head Nod Yes
   servohead_yes_nod();
    Serial.println("RETURNED FROM yes_nod()MONKEY01");    
    // send MONKEY 11 (done) to USIP 

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

// Is it Head Nod No?
if (MonkCMDStr.equals("MONKEY 02")){
   Serial.println("Command equals MONKEY 02");
    // set any flags
    // call Head Nod No
  //    servohead_no_nod();
 servohead_no_nod();
 Serial.println("RETURNED FROM no_nod()MONKEY02");   
    
    // send MONKEY 11 (done) to USIP 
    
     monkey_rest(); // bring monkey to default positions
     
    Serial.print("MONKEY 11 (done) Signal");
    Serial2.println("MONKEY 11");
      validcmd_flg = true;
}

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

// Is it Scan Head?
if (MonkCMDStr.equals("MONKEY 04")){
    Serial.println("Command equals MONKEY 04");
    // set any flags
    // call Scan Head
    scanhead();
     Serial.println("RETURNED FROM scan_head()MONKEY04"); 
    // send MONKEY 11 (done) to USIP
      monkey_rest(); // bring monkey to default positions
    Serial.print("MONKEY 11 (done) Signal");
  Serial2.println("MONKEY 11");
    validcmd_flg = true;
}
// Is it Left Hand Wave?
if (MonkCMDStr.equals("MONKEY 05")){
    Serial.println("RETURNED FROM left_hand_wave()MONKEY05"); 
    // set any flags
    // call Left Hand Wave
    left_arm ();
    // send MONKEY 11 (done) to USIP
      monkey_rest(); // bring monkey to default positions
    Serial.print("MONKEY 11 (done) Signal");
    Serial2.println("MONKEY 11");
    validcmd_flg = true;
}
// Is it a chest pound?
if (MonkCMDStr.equals("MONKEY 06")){
    Serial.println("RETURNED FROM chest_pound()MONKEY06"); 
    // set any flags
    // call Chest Pound
    monkey_chest();
    // send MONKEY 11 (done) to USIP
      //monkey_rest(); // bring monkey to default positions
      monkey_rest(); // bring monkey to default positions
    Serial.print("MONKEY 11 (done) Signal");
   Serial2.println("MONKEY 11");
   validcmd_flg = true;
}
// Is it a touchdown signal?
if (MonkCMDStr.equals("MONKEY 07")){
    Serial.println("Command equals MONKEY 07");
    // set any flags
     monkey_touchdown(); // monkey to raise both arms up at once
     Serial.println("MONKEY 07 (touchdown) Signal");
     Serial2.println("MONKEY 11");
      //monkey_rest(); // bring monkey to default positions
      monkey_rest(); // bring monkey to default positions
    Serial.print("MONKEY 11 (done) Signal");
    Serial2.println("MONKEY 11");
    validcmd_flg = true;
}
// Is it all motions executed once?
if (MonkCMDStr.equals("MONKEY 08")){
    Serial.println("Command equals MONKEY 08");
    // set any flags
    // call Monkey Motions
      servohead_no_nod();
       servohead_yes_nod();
       scanhead(); //Full scan
       right_arm2(); // Thumbs up right arm
       left_arm (); // Wave left arm
       monkey_chest();  // Chest pound

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

/////////////////////////////////////////////////////////////////////////////////////////////////////////////////////////////////////////////

/////////////Monkey Commands//////////////////

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

    pwm.setPWM(0,0,botHead0); //start bottom servo head at middle position
    delay(2);

    pwm.setPWM(1,0,pos); //move top servo head down in increments
    delay(5);

 }

//for (pos = 400; pos >= 300; pos -= 1) { 
  for (pos = topHead1 + 150; pos >= topHead1; pos -= 1) {

      pwm.setPWM(1,0,pos); //move top servo head up in increments
      delay(5);
  
  }// 1st round

//2nd round:

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

} //end servohead_yes_nod

//////////////////////////////////////////////////////////////////////////////////////////////////////////

void servohead_no_nod() {
//Servo1 left and right motion

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

 pwm.setPWM(1,0,topHead1); //top servo head
      delay(5);
  }

for (pos = botHead0 + 90; pos >= botHead0 - 90; pos -= 1) { 

  pwm.setPWM(0,0,pos);
  delay(2);
 
}  //1st round

//2nd round:

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

    pwm.setPWM(1,0,topHead1); //top servo head
      delay(5);

  }

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

 pwm.setPWM(1,0,topHead1); //top servo head
      delay(5);
  }

for (pos = botHead0 + 90; pos >= botHead0 - 90; pos -= 1) { 

  pwm.setPWM(0,0,pos);
  delay(2);
 
}  //1st round

//2nd round:

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

    pwm.setPWM(1,0,topHead1); //top servo head
      delay(5);

  }

}//end of no nod

//////////////////////////////////////////////////////////////////////////////////////////////////////////

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

//hand wave 1st cycle:

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

//hand wave 2nd cycle

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

////////////////////////////////////

//////////Returning shoulder back to original position///////////////////////

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

}//end of left arm

/////////////////////////////////////////////////////////////////////////////////////////////////////////////

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

    pwm.setPWM(0,0,pos); //bottom servo head
    //pos2=SERVOMIN;
    delay(5);

    pwm.setPWM(1,0,pos-150); //top servo head RH
      delay(5);

  }

for (pos = botHead0 + 100; pos >= botHead0; pos -= 1) { 

  pwm.setPWM(0,0,pos);
  delay(15);

      pwm.setPWM(1,0,pos-150); //top servo head
      delay(5);
  
}

}//end of servohead2 

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

    pwm.setPWM(0,0,pos); //bottom servo head
    //pos2=SERVOMIN;
    delay(5);

    pwm.setPWM(1,0,pos+50); //top servo head
      delay(5);

  }

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

      pwm.setPWM(1,0,pos+50); //top servo head
      delay(5);
  
}

}///////////////////end of scan head

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

} //end right_arm

////////////////////////////////////////////////////////////////////////////////////////

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

  ///>>>>>>>>>Right arm Movement>>>>>////////

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

//Right forearm motion: 1st cycle

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

// left forearm motion: 1st cycle

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

//Right forearm motion: 2nd motion

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

// left forearm motion: 2nd motion

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

////////

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

} //end chest movement

///////////////////////////////////////////////////////////////////////

//Communication section - taking in initial commands

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

                    Xavier = inStr0.substring(0,9);

                    Serial.println("The substring is: " + Xavier);

                 //   line = "\n";
                //    Xavier.concat(line);

                    MonkeyCmd_str = Xavier;

                //    Serial.print( MonkeyCmd_str,HEX);

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

          ///////////////////////*/
       //    MonkeyFlag= true;
       //   MonkeyCmd_str = "MONKEY 12";   
//// TESTING////////////////////////////////////////////////////////////           

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

                    Xavier2 = inStr2.substring(0,9);

                    Serial.println("The substring is: " + Xavier2);

                 //   line = "\n";
                //    Xavier.concat(line);

                    MonkeyCmd_str = Xavier2;

                //    Serial.print( MonkeyCmd_str,HEX);

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

             }

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

}

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

/////////////////////////////////////////////////////////////////////////////////
// Monkey Touchdown
void monkey_touchdown(){  //pin 5 - on servo board 
  Serial.println("Entered monkey touch down() ");

  touchdown_head_bottom_servo_();
  touchdown_head_top_servo_();
  touchdown_right_elbow_go_home();
  left_elbow_go_home(); 
  touchdown_left_arm_go_up();  
  right_arm_go_up();

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

  }

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

///////////////////////////////////////////////////////////////////////////////////////
//this issues the command to turn the video OFF

void video_off(){
  Serial.println("Entered video_off()");
      digitalWrite(VIDEO_pin, LOW);
}

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

int video_on(){
  int video_status;
    Serial.println("Entered video_on()");
    digitalWrite(VIDEO_pin, HIGH);
    set_video_level(52);  // set video to mid level of 52
    delay (100);
    // query the video R U there?

return (video_status);
}

///////////////// Set Video Level ////////////////////////////////////////////////
//I2CVIDEOADDR  IS #def'd at top and is the video device I2C address
//
void set_video_level(int video_level){
      Serial.println("Entered set_video_level()");
      Serial.print("setting the video level to ");
      Serial.println(video_level);    
      Wire.beginTransmission(I2CVIDEOADDR);  // transmit to device
      Wire.write(video_level);
      Wire.endTransmission();    // stop transmitting
     
}

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

BatRead3 = analogRead(BatteryVoltagePin);  // read the input pin for the 3rd time

// calculate the voltages from the ADC  read values
BatV1 = (((float)BatRead1)/204.6) * DivideByCircuit;

BatV2 = (((float)BatRead2)/204.6) * DivideByCircuit;

BatV3 = (((float)BatRead3)/204.6) * DivideByCircuit;

BatSum = BatV1+BatV2+BatV3;
BatMean = (BatSum/3.0);
TenTimes = (int)(BatMean * 10.0);

return (TenTimes);

     }

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

 int get_inside_temp(){
      int T_inside = 0;
      TRaw  = analogRead(InsideTempPin);  // read the inside temp 
      /// TEST
      /// TRaw = 1023;
       
      TempK = (TRaw/2.046);
      TempC = TempK - 273.15;
      T_inside = (int) TempC;
 return (T_inside);
      }

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

 int get_xmtr_temp(){   // this routine reads the transmitter temperature
      int xmtr_temp = 0;
      XTRaw  = analogRead(XmtrTempPin);      // read transmitter temperature
      // TEST
     // XTRaw = 1024/2;
      
      XTempK = (XTRaw/2.046);
      XTempC = XTempK - 273.15;
      xmtr_temp = (int) XTempC;
 return (xmtr_temp);
      }
//////////////////////////////////////////////////////////////////////////////
