huonghuy/High-Altitude-Monkey/Posters-Presentations/ASEE - HARM Paper/Chapters/0_frontpage.tex

\begin{center}

    \vspace*{-2cm} % Adjust this value to move the content up
    {\fontsize{14pt}{17pt}\selectfont\bfseries Student Paper} \\
    {\fontsize{14pt}{17pt}\selectfont\bfseries Work in Progress: High Altitude Robotic Monkey} \\

\end{center}
