huonghuy/High-Altitude-Monkey/Software list.docx

Software list

- EasyEda (PCB)
  - Cons: Not version controlled, not easily shareable
- Arduino IDE (Code)
- CH340 driver for alt Mega 2560 (Board)
- OnShape account (CAD)
  - Onshape.com
