huonghuy/High-Altitude-Monkey/OnShape Links.docx

HAM Control box: https://cad.onshape.com/documents/80553ebf480181622a4d5b03/w/350ecadc1d7df8ef7b9a28ef/e/155316edb1448a3449d366cc

HAM body (Puppet): https://cad.onshape.com/documents/80553ebf480181622a4d5b03/w/350ecadc1d7df8ef7b9a28ef/e/155316edb1448a3449d366cc

HAM Grey Box (Land Module):

https://cad.onshape.com/documents/80553ebf480181622a4d5b03/w/350ecadc1d7df8ef7b9a28ef/e/155316edb1448a3449d366cc
