huonghuy/High-Altitude-Monkey/Backup Files/USIP/Landing.docx

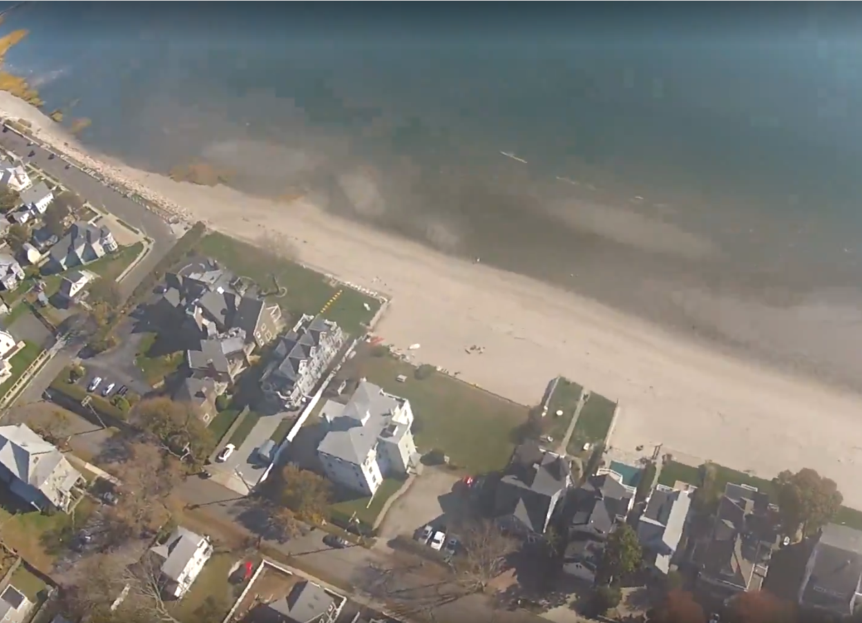
[picture p5: figure]

Landing
