huonghuy/High-Altitude-Monkey/Backup Files/USIP/APRS.docx

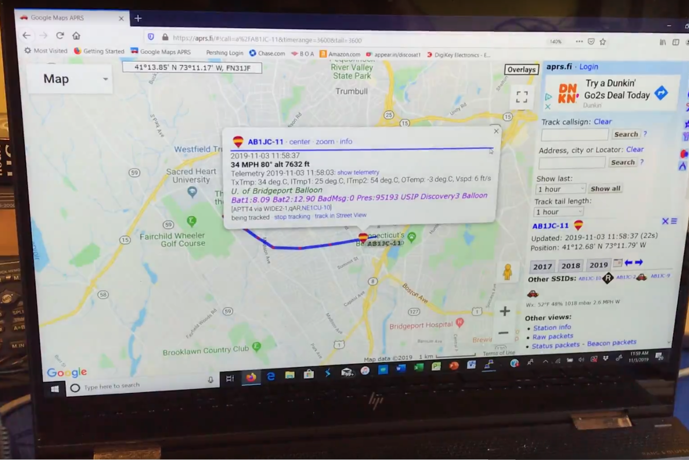
[picture p7: figure]
