huonghuy/High-Altitude-Monkey/Backup Files/USIP/Flight Path.docx

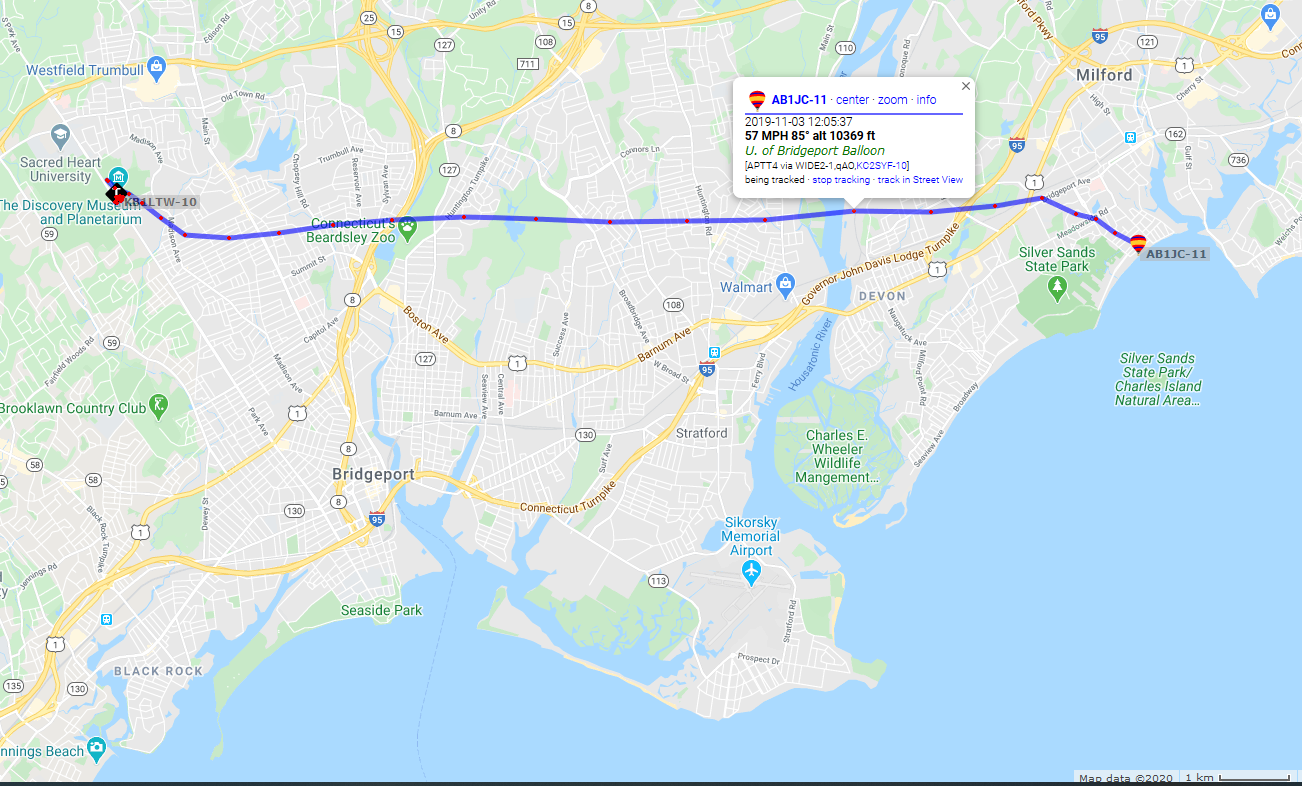
[picture p8: figure]
