huonghuy/High-Altitude-Monkey/Backup Files/USIP/Ground Station.docx

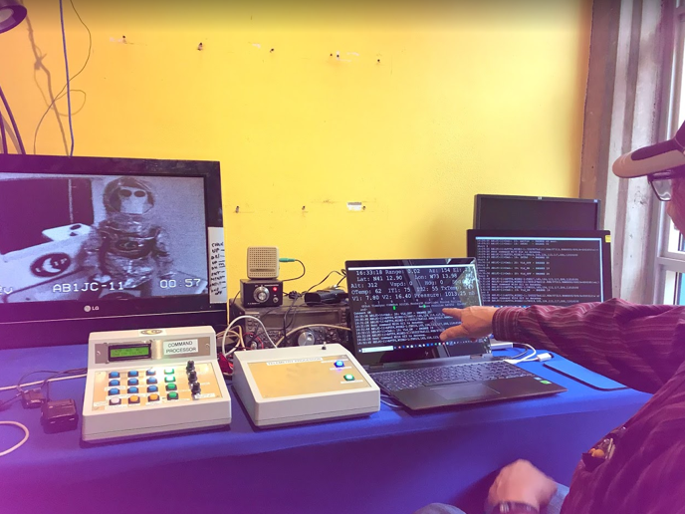
[picture p9: figure]
