huonghuy/High-Altitude-Monkey/Backup Files/USIP/Ham.docx

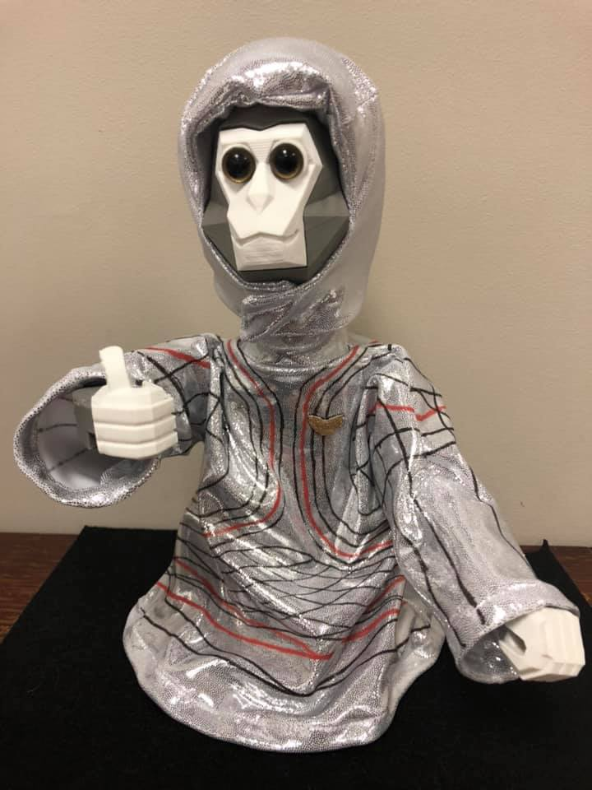
[picture p10: figure]
