huonghuy/High-Altitude-Monkey/Backup Files/USIP/Inflation.docx

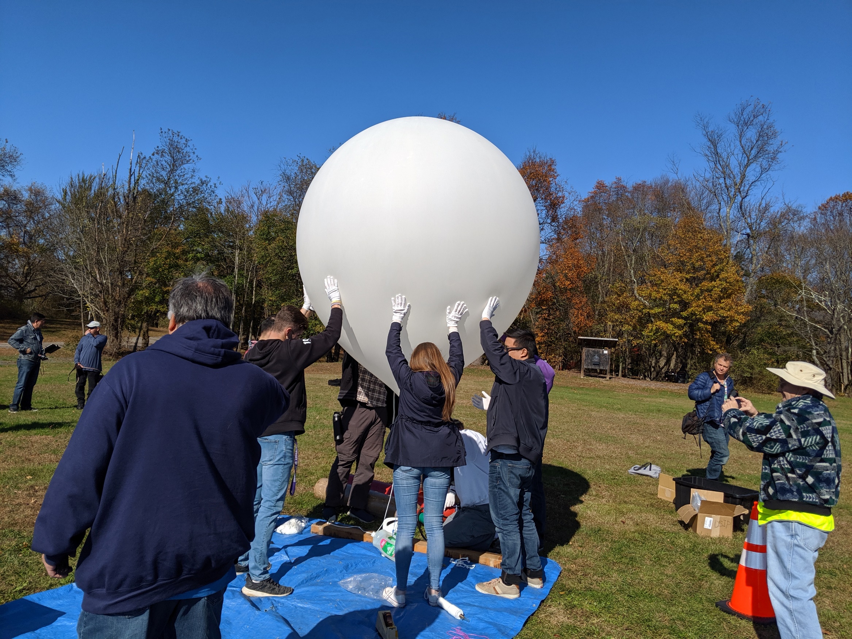
[picture p11: figure]
