huonghuy/High-Altitude-Monkey/Backup Files/USIP/Launch_pic.docx

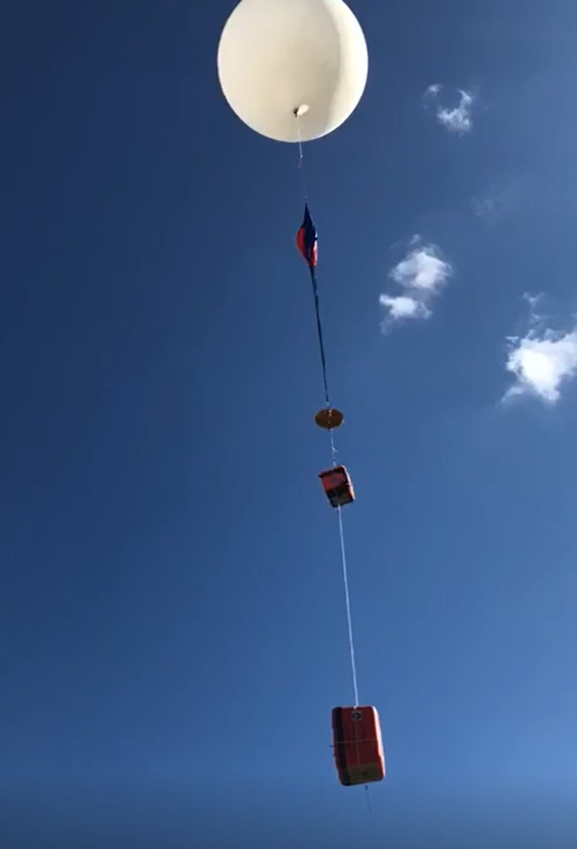
[picture p12: figure]
