huonghuy/High-Altitude-Monkey/Backup Files/USIP/Launch_pic1.docx

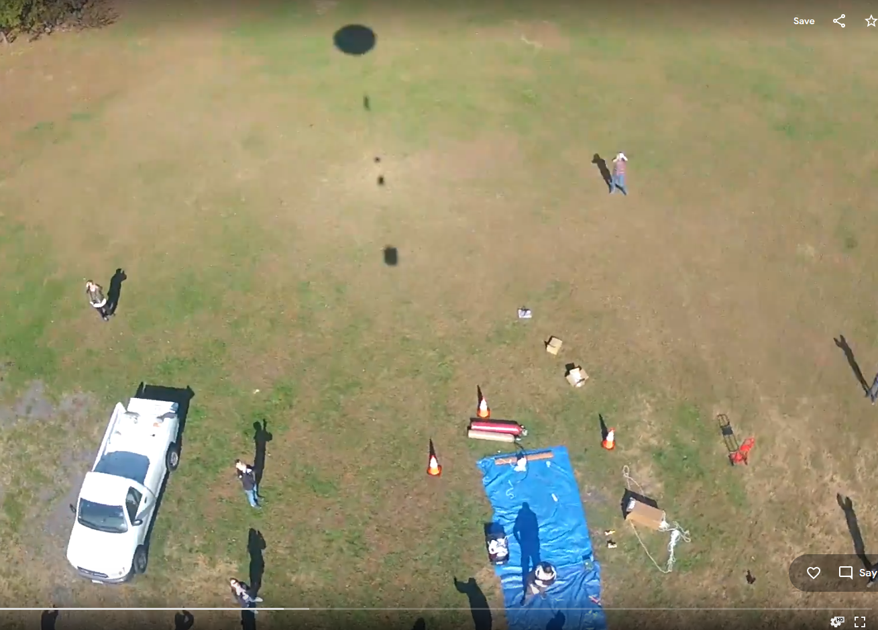
[picture p13: figure]
