huonghuy/High-Altitude-Monkey/Backup Files/USIP/Museum from balloon.docx

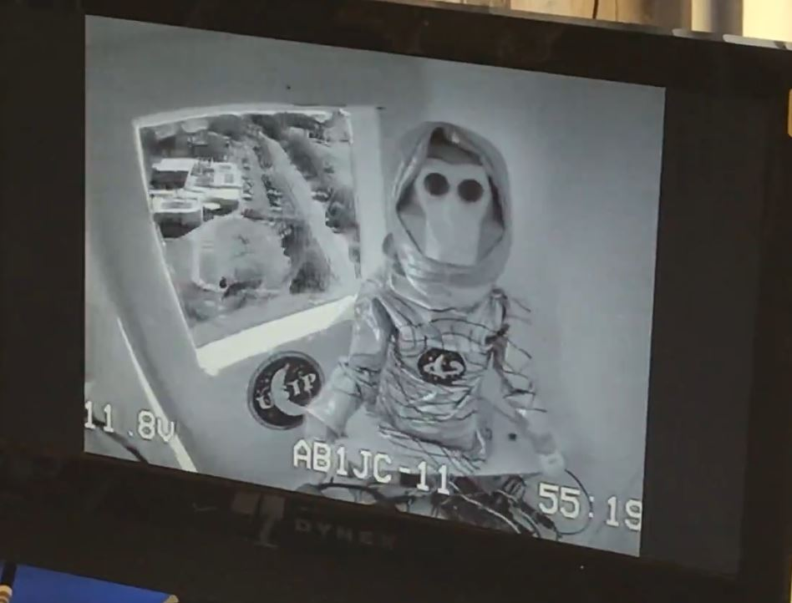
[picture p14: figure]
