huonghuy/High-Altitude-Monkey/Backup Files/USIP/Telemetry Screen.docx

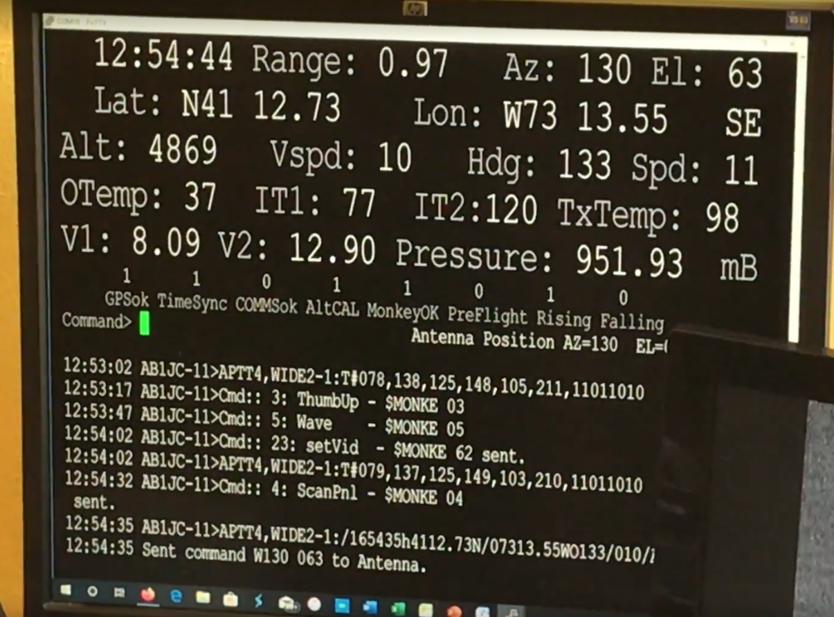
[picture p15: figure]
