huonghuy/High-Altitude-Monkey/Documentation/DSD TECH HC-05.pdf

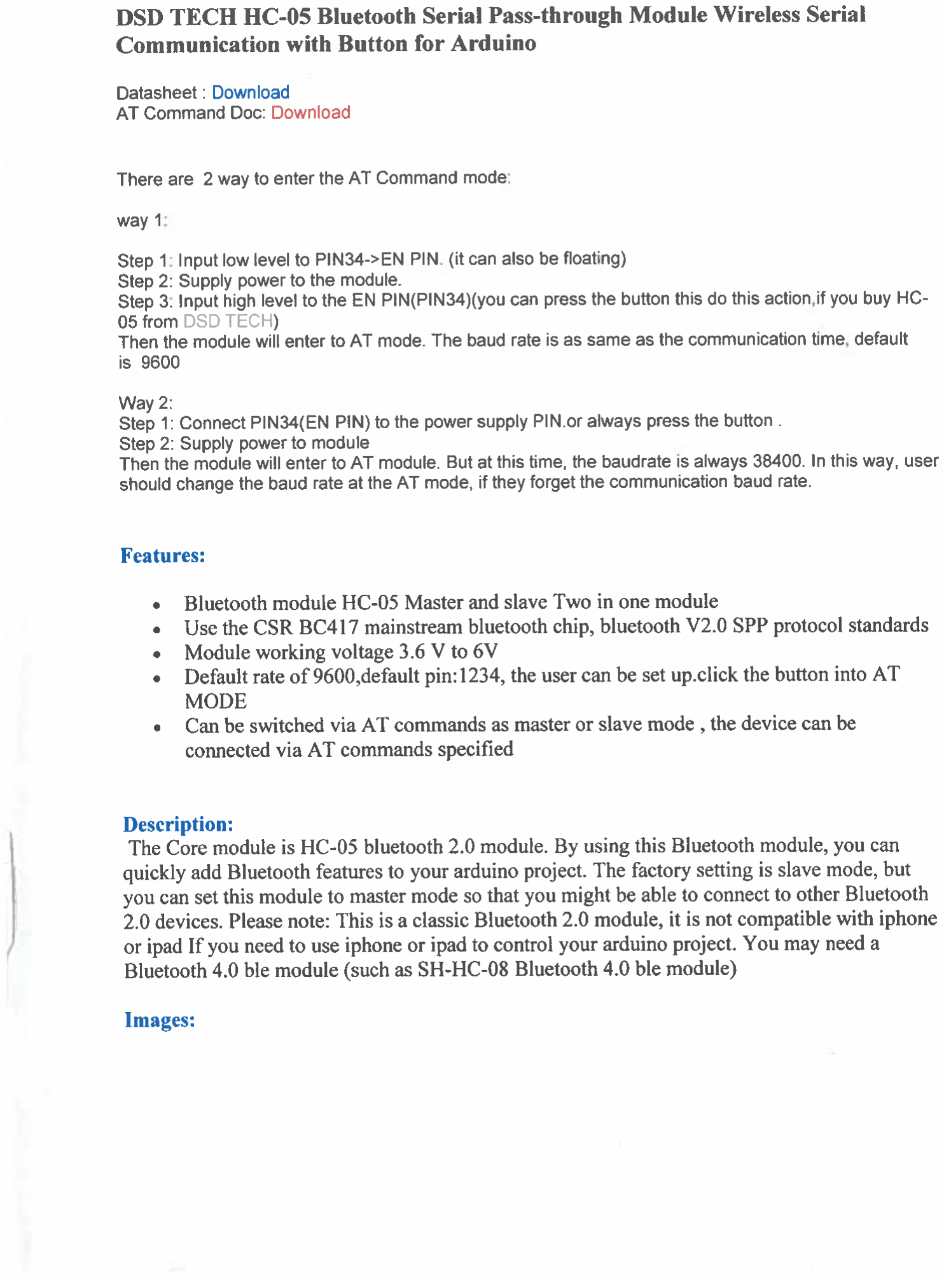
[picture p16: page 1]
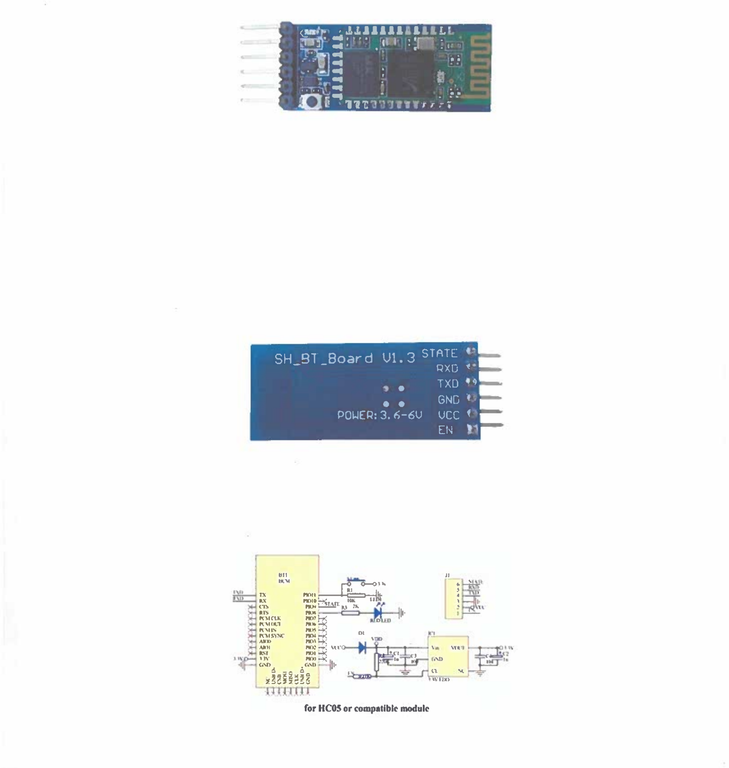
[picture p17: page 2]
