huonghuy/High-Altitude-Monkey/Pictures/GRAW DFM-17 Website.jpg

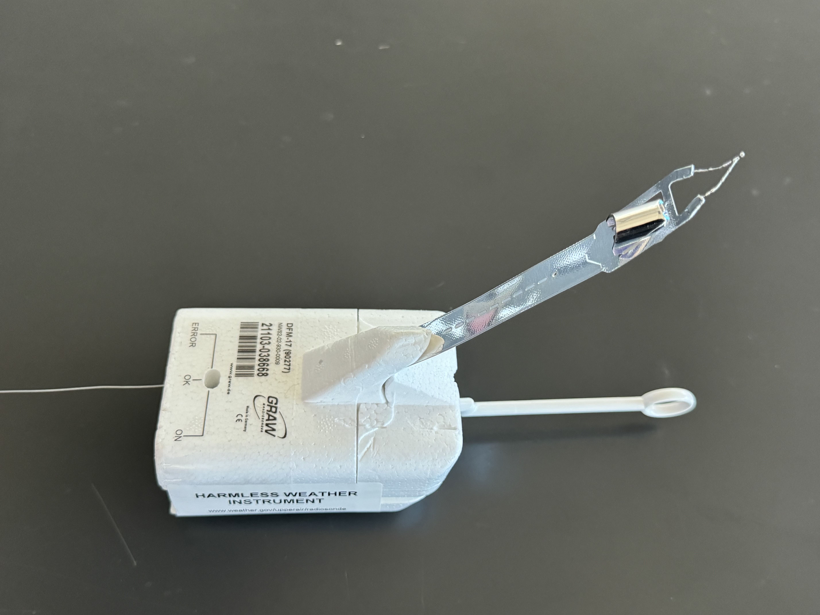
Pictures/GRAW DFM-17 Website.jpg
