huonghuy/High-Altitude-Monkey/Pictures/HAM Ground.drawio (1).png

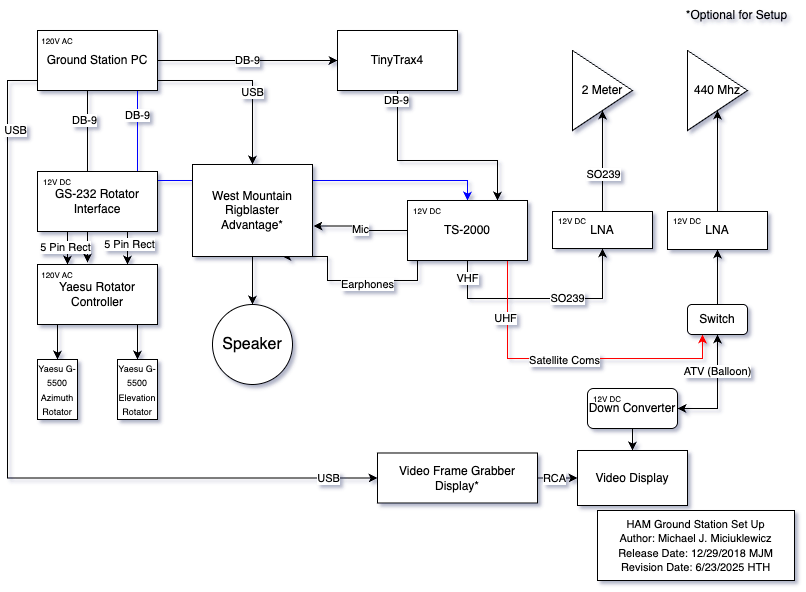
Pictures/HAM Ground.drawio (1).png
