huonghuy/High-Altitude-Monkey/Pictures/Ham_the_chimp_(cropped).jpg

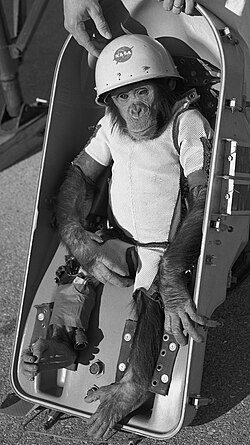
Pictures/Ham_the_chimp_(cropped).jpg
