huonghuy/High-Altitude-Monkey/Pictures/PCB_PCB_HAM_2025-06-18.png

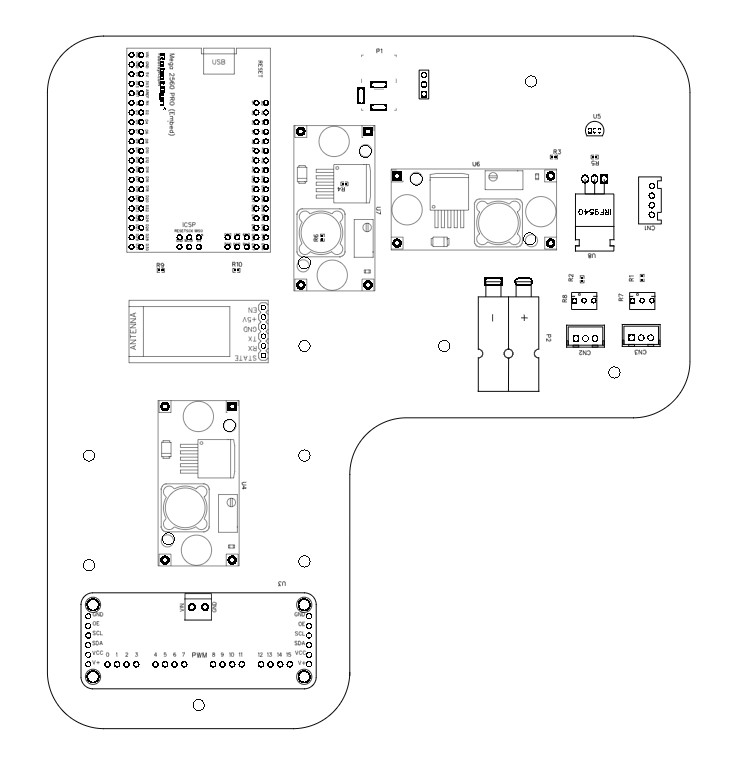
Pictures/PCB_PCB_HAM_2025-06-18.png
