huonghuy/High-Altitude-Monkey/Pictures/PCB_PCB_HAM_2025-06-19.png

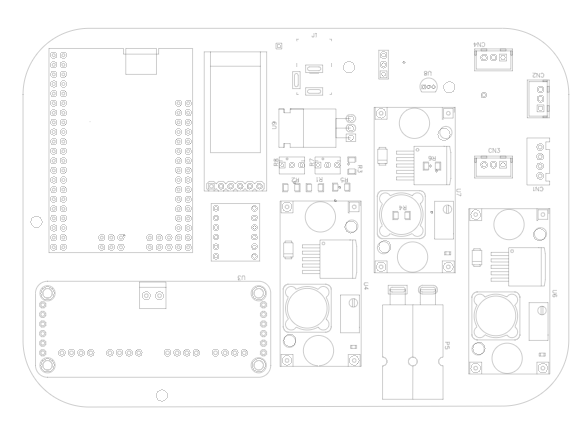
Pictures/PCB_PCB_HAM_2025-06-19.png
