huonghuy/High-Altitude-Monkey/Posters-Presentations/ASEE_HARM.png

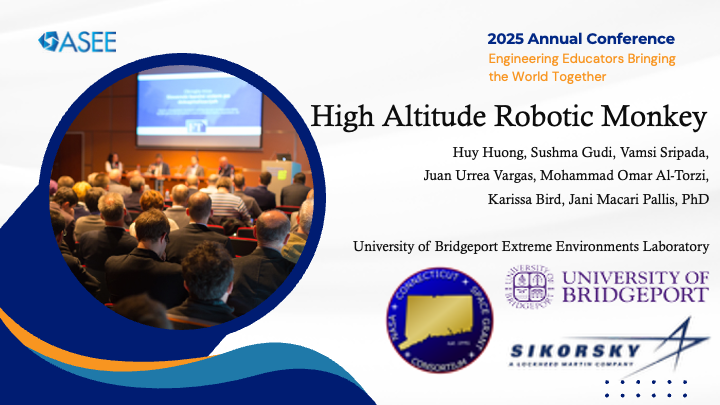
Posters-Presentations/ASEE_HARM.png
