huonghuy/High-Altitude-Monkey/Schematics/Mega-Pro-Mini.jpeg

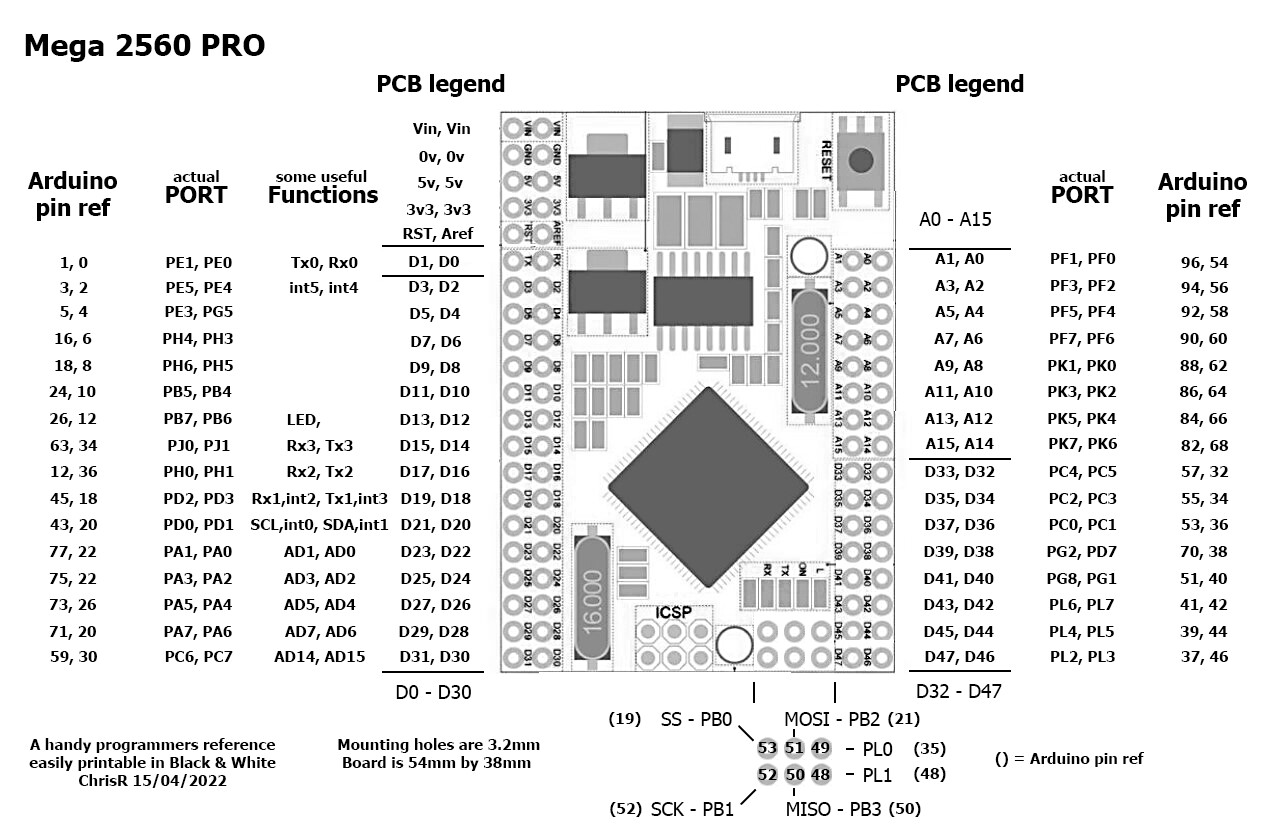
Schematics/Mega-Pro-Mini.jpeg
