huonghuy/High-Altitude-Monkey/Purchase Orders/HAM_BOM_PCB_Distributors.xlsx

Sheet: Mouser
Item | Link | Quantity | Unit Price | Total
DS1809-010 | https://mou.sr/3W7q0MQ | 1
2N2904 Transistor | https://mou.sr/4gISDIj | 1

Sheet: Adafruit
Item | Link | Quantity | Unit Price | Total

Sheet: Addicore
Item | Link | Quantity | Unit Price | Total
22 Ohm 1/4W Metal Film | https://www.addicore.com/products/22-ohm-1-4w-precision-resistor | 1 | 0.10 | 0.10
33 Ohm 1/4W Metal Film | https://www.addicore.com/products/33-ohm-1-4w-precision-resistor | 7 | 0.10 | 0.70
820 Ohm 1/4W Metal Film | https://www.addicore.com/products/820-ohm-1-4w-precision-resistor | 1 | 0.10 | 0.10
1.5k Ohm 1/4W Metal Film | https://www.addicore.com/products/1-5k-ohm-1-4w-precision-resistor | 1 | 0.10 | 0.10
1.8k Ohm 1/4W Metal Film | https://www.addicore.com/products/1-8k-ohm-1-4w-precision-resistor | 1 | 0.10 | 0.10
2.2k Ohm 1/4W Metal Film | https://www.addicore.com/products/2-2k-ohm-1-4w-precision-resistor | 1 | 0.10 | 0.10
2.7k Ohm 1/4W Metal Film | https://www.addicore.com/products/2-7k-ohm-1-4w-precision-resistor | 1 | 0.10 | 0.10
3.3k Ohm 1/4W Metal Film | https://www.addicore.com/products/3-3k-ohm-1-4w-precision-resistor | 1 | 0.10 | 0.10
3.9k Ohm 1/4W Metal Film | https://www.addicore.com/products/3-9k-ohm-1-4w-precision-resistor | 2 | 0.10 | 0.20
8.2k Ohm 1/4W Metal Film | https://www.addicore.com/products/8-2k-ohm-1-4w-precision-resistor | 1 | 0.10 | 0.10
10k Ohm 1/4W Metal Film | https://www.addicore.com/products/10k-ohm-1-4w-precision-resistor | 1 | 0.10 | 0.10
12k Ohm 1/4W Metal Film | https://www.addicore.com/products/12k-ohm-1-4w-precision-resistor | 1 | 0.10 | 0.10
 |  |  |  | 1.90

Sheet: Amazon
Item | Link | Quantity | Unit Price | Total

Sheet: DigiKey
Item | Link | Quantity | Unit Price | Total

Sheet: PowerWerx
Item | Link | Quantity | Unit Price | Total

Sheet: Sparkfun
Item | Link | Quantity | Unit Price | Total
BOB-12009 | http://sfe.io/p12009 | 2
