huonghuy/High-Altitude-Monkey/Purchase Orders/HAM PO/HAM Pending.xlsx

Item | Link | Quantitiy | Unit Price | Total | Vendor
10 k Pot, 10 turn, PCB Mount | LINK (https://www.digikey.com/product-detail/en/bourns-inc/3266Y-1-103LF/3266Y-1-103LF-ND/2535458) | 4 | $4.20 | $16.80 | DigiKey
LM135 Temperature Sensors | LINK (https://www.digikey.com/product-detail/en/texas-instruments/LM135H/296-38979-ND/5055948) | 4 | $12.14 | $48.56 | DigiKey
P-Channel MOSFET | LINK (https://www.digikey.com/products/en?keywords=IRF9540NPbF) | 1 | $1.99 | $1.99 | DigiKey
PAN/TILT BRACKET KIT | LINK (https://www.digikey.com/en/products/detail/sparkfun-electronics/ROB-14391/7675361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) | 1 | $7.50 | $7.50 | DigiKey
Parallax 2 x 16 Serial LCD | LINK (https://www.parallax.com/product/27977) | 1 | $34.95 | $34.95 | Parallax INC
Pack of 10, 3.5mm Stereo Jack Connector | LINK (https://www.amazon.com/gp/product/B01C3RFHDC/ref=ppx_yo_dt_b_asin_title_o06_s00?ie=UTF8&psc=1) | 1 | $7.99 | $7.99 | Amazon
Relay Module | LINK (https://smile.amazon.com/HiLetgo-Channel-optocoupler-Support-Trigger/dp/B00LW15A4W?s=industrial) | 1 | $7.39 | $7.39 | Amazon
TT USB Cable | LINK (https://www.byonics.com/cables) | 1 | $23 | $23 | Byonics
UHF Television Transmitter | LINK (http://www.hamtv.com/videolynx.html) |  | $199 | $199 | HAM Tv
