huonghuy/High-Altitude-Monkey/Purchase Orders/HAM PO/PO_11_06_24 (HomeDepot).xlsx

Item | Link | Quantitiy | Unit Price | Total
Ground plane metal sheet (for USIP and Monkey boxes) | LINK (https://www.homedepot.com/p/M-D-Building-Products-3-ft-x-3-ft-Aluminum-Venetian-Bronze-Lincane-Sheet-57015/202525469) | 1 | $49.93 | $49.93
Metal Shield 24" x 36" x .019 | LINK (https://www.homedepot.com/p/M-D-Building-Products-36-in-x-36-in-Plain-Aluminum-Sheet-in-Silver-57000/100351161) | 1 | $34.47 | $34.47
5 minute Epoxy | LINK (https://www.homedepot.com/p/J-B-Weld-0-85-oz-ClearWeld-Quick-Set-Epoxy-Syringe-50112/204986141) | 3 | $7.78 | $23.34
 |  |  | Total | $107.74
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
