huonghuy/High-Altitude-Monkey/Purchase Orders/HAM PO/PO_11_06_24(Bioenno).xlsx

Item | Link | Quantitiy | Unit Price | Total
Bioenno Lithium Iron Phosphate Battery | LINK (https://www.bioennopower.com/products/12v-3ah-lifepo4-battery-pvc?variant=5597832904734) | 2 | $64.99 | 129.98
 |  |  | Total | 129.98
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
