huonghuy/High-Altitude-Monkey/Purchase Orders/HAM PO/PO_11_06_24(Byonics).xlsx

Item | Link | Quantitiy | Unit Price | Total
TT USB Cable | LINK (https://www.byonics.com/cables) | 1 | $23 | $23
 |  |  | Total | $23
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
