huonghuy/High-Altitude-Monkey/Purchase Orders/HAM PO/PO_11_06_24(Digi-Key).xlsx

Item | Link | Quantitiy | Unit Price | Total
10 k Pot, 10 turn, PCB Mount | LINK (https://www.digikey.com/product-detail/en/bourns-inc/3266Y-1-103LF/3266Y-1-103LF-ND/2535458) | 4 | $4.20 | $16.80
LM135 Temperature Sensors | LINK (https://www.digikey.com/product-detail/en/texas-instruments/LM135H/296-38979-ND/5055948) | 4 | $12.14 | $48.56
P-Channel MOSFET | LINK (https://www.digikey.com/products/en?keywords=IRF9540NPbF) | 1 | $1.99 | $1.99
PAN/TILT BRACKET KIT | LINK (https://www.digikey.com/en/products/detail/sparkfun-electronics/ROB-14391/7675361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) | 1 | $7.50 | $7.50
 |  |  | Total | $74.85
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
