huonghuy/High-Altitude-Monkey/Purchase Orders/HAM PO/PO_11_06_24(powerwerx).xlsx

Item | Link | Quantitiy | Unit Price | Total
Power Poles and distribution x4 | LINK (https://powerwerx.com/4-position-powerpole-distribution-block) | 1 | 34.99 | 34.99
 |  |  | Total | 34.99
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
