huonghuy/High-Altitude-Monkey/Purchase Orders/PO_05_02_25/PO_05_02_25.xlsx

Item | Link | Quantitiy | Unit Price | Total
JLCPCB Custom PCB Order | https://jlcpcb.com | 1 | 47.07 | 47.07
 |  |  |  | 47.07
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
