huonghuy/High-Altitude-Monkey/Purchase Orders/PO_06_01_25/PO_06_01_25.xlsx

Item | Link | Quantitiy | Unit Price | Total
JLCPCB Custom Order - 4 PCB's Default Settings, 5 Per PCB - Green | https://jlcpcb.com | 1 | 47.3 | 47.3
 |  |  |  | 47.3
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
