huonghuy/High-Altitude-Monkey/Purchase Orders/PO_21_03_25/PO_21_03_25.xlsx

Item | Link | Quantitiy | Unit Price | Total
JLCPCB Custom PCB Order | https://jlcpcb.com | 1 | 59.17 | 59.17
 |  |  |  | 59.17
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
