huonghuy/High-Altitude-Monkey/Purchase Orders/HAM PO/PO_11_06_24 (parallax INC).xlsx

Item | Link | Quantitiy | Unit Price | Total
Parallax 2 x 16 Serial LCD | LINK (https://www.parallax.com/product/27977) | 1 | $34.95
 |  | Total | $34.95
