huonghuy/High-Altitude-Monkey/Purchase Orders/HAM PO/PO_11_06_24(Ham Tv).xlsx

Item | Link | Quantitiy | Unit Price | Total
UHF Television Transmitter | LINK (http://www.hamtv.com/videolynx.html) |  | $199 | $199
 |  |  | Total | $199
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
