huonghuy/High-Altitude-Monkey/Models/STL Folder/Completed right-middle arm part 2 of 2.stl

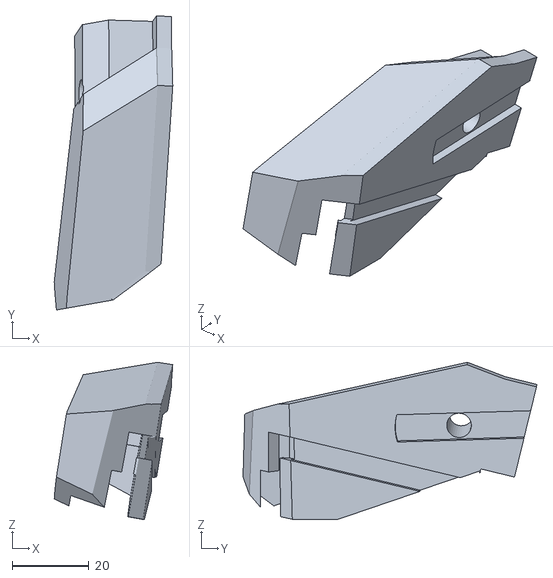
[picture p26: CAD file, 2025-09-03]
Models/STL Folder/Completed right-middle arm part 2 of 2.stl
30.8 x 76.5 x 40.9
