huonghuy/High-Altitude-Monkey/Models/STL Folder/completed right arm part1 of 2.stl

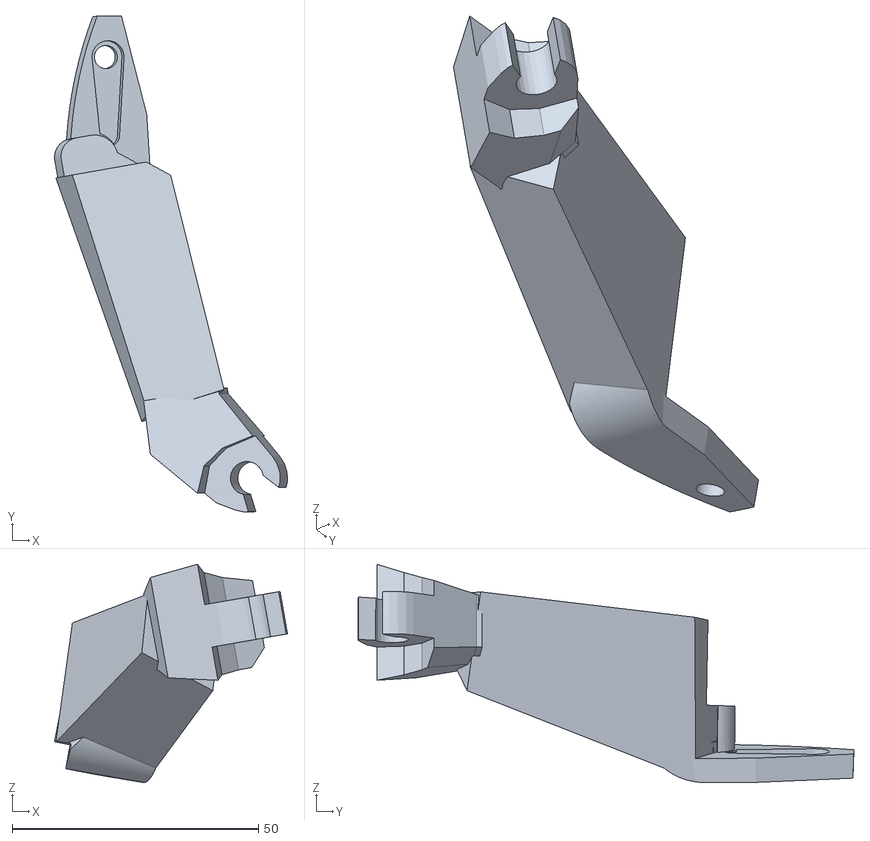
[picture p27: CAD file, 2025-09-03]
Models/STL Folder/completed right arm part1 of 2.stl
47.3 x 100.7 x 44.4
