huonghuy/High-Altitude-Monkey/Models/STL Folder/Completed left arm part 2 of 2.stl

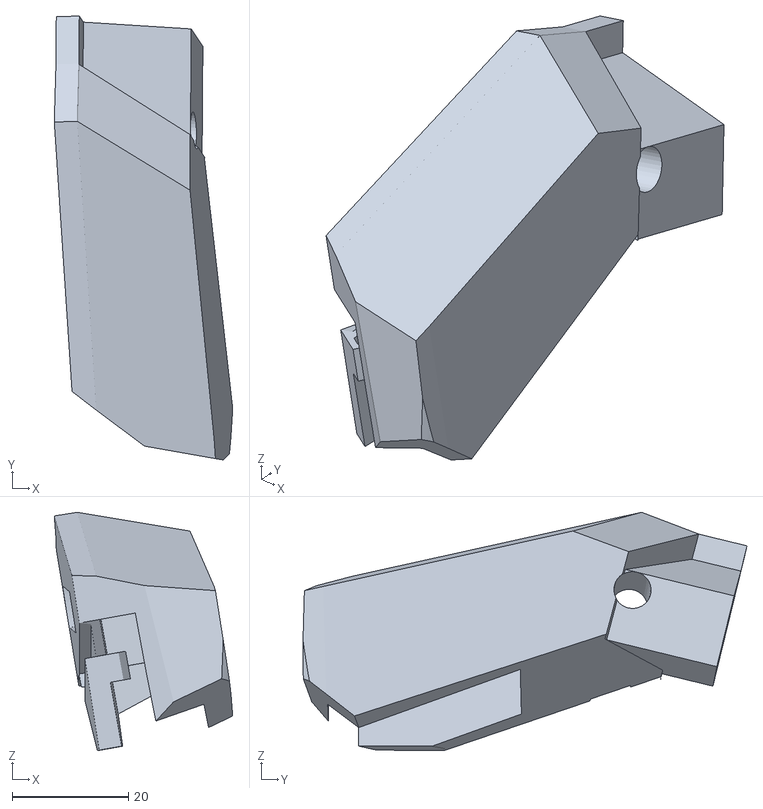
[picture p28: CAD file, 2025-09-03]
Models/STL Folder/Completed left arm part 2 of 2.stl
30.6 x 76.3 x 40.9
