huonghuy/High-Altitude-Monkey/Models/Output/HAM MC Output Panel V1.9.3mf

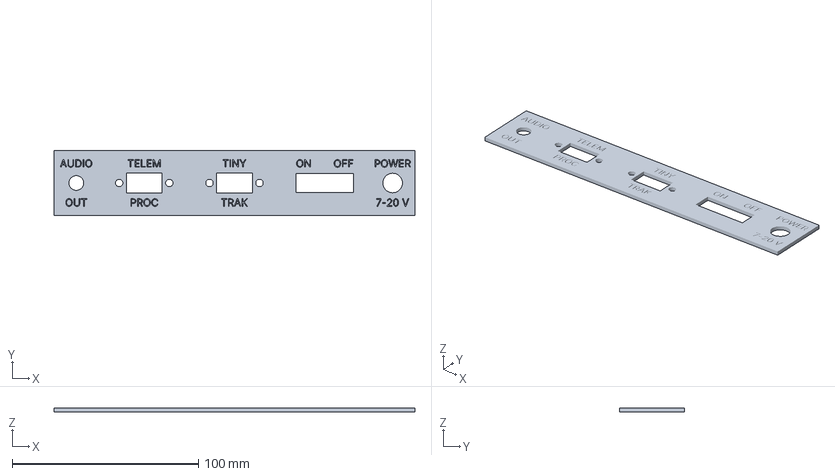
[picture p29: CAD file, 2025-06-16]
Models/Output/HAM MC Output Panel V1.9.3mf
194.0 x 35.0 x 2.20 mm
