huonghuy/High-Altitude-Monkey/Models/Panel/HAM_MC_Plate-V0.3BH.3MF

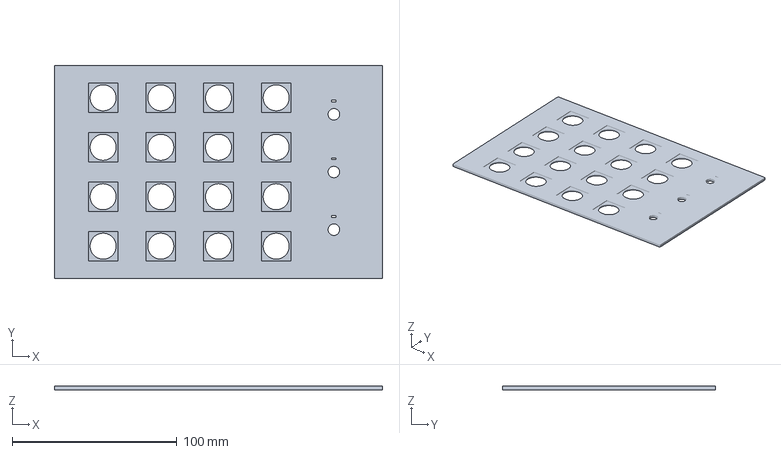
[picture p30: CAD file, 2025-06-16]
Models/Panel/HAM_MC_Plate-V0.3BH.3MF
199.0 x 129.3 x 2.13 mm
