huonghuy/High-Altitude-Monkey/Models/STL Folder/final SERVO HEAD.stl

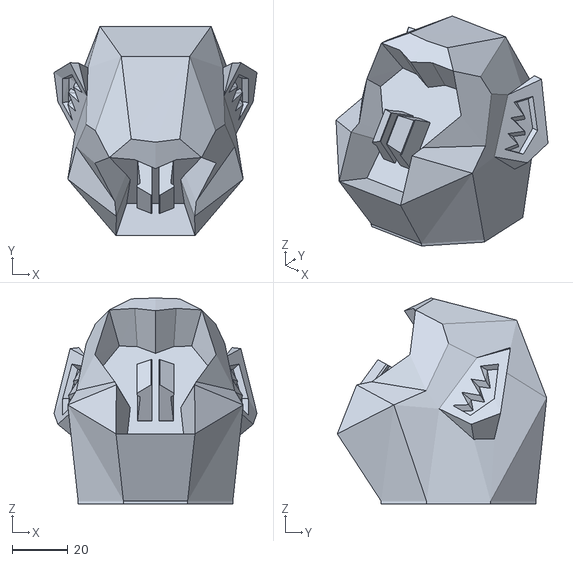
[picture p31: CAD file, 2025-09-03]
Models/STL Folder/final SERVO HEAD.stl
72.8 x 75.1 x 73.9
