huonghuy/High-Altitude-Monkey/Models/TorsoUB.stl

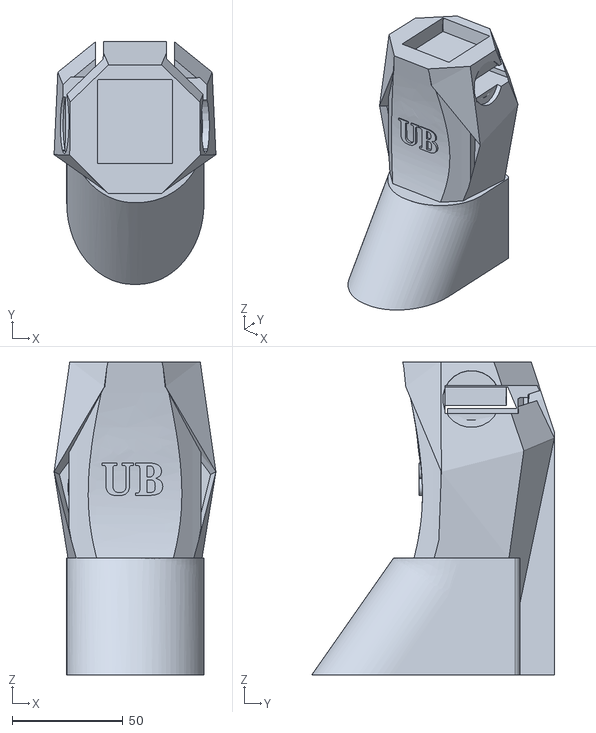
[picture p32: CAD file, 2025-09-03]
Models/TorsoUB.stl
73.1 x 109.6 x 141.4
