huonghuy/High-Altitude-Monkey/Schematics/OBJ_PCB_HAM_2024-12-10/OBJ_PCB_HAM.obj

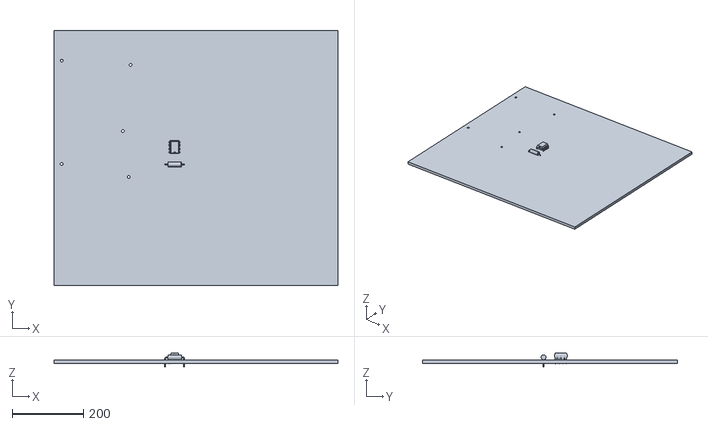
[picture p33: CAD file, 2025-06-16]
Schematics/OBJ_PCB_HAM_2024-12-10/OBJ_PCB_HAM.obj
798.8 x 718.3 x 38.2
