huonghuy/High-Altitude-Monkey/Models/New HAM Body.stl

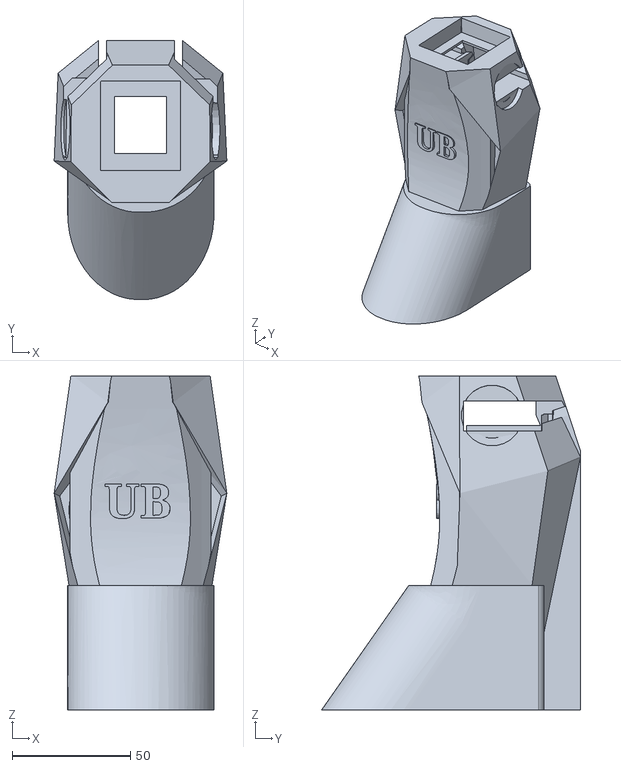
[picture p34: CAD file, 2025-06-16]
Models/New HAM Body.stl
73.1 x 109.6 x 141.3
