huonghuy/High-Altitude-Monkey/Models/STL Folder/Face.stl

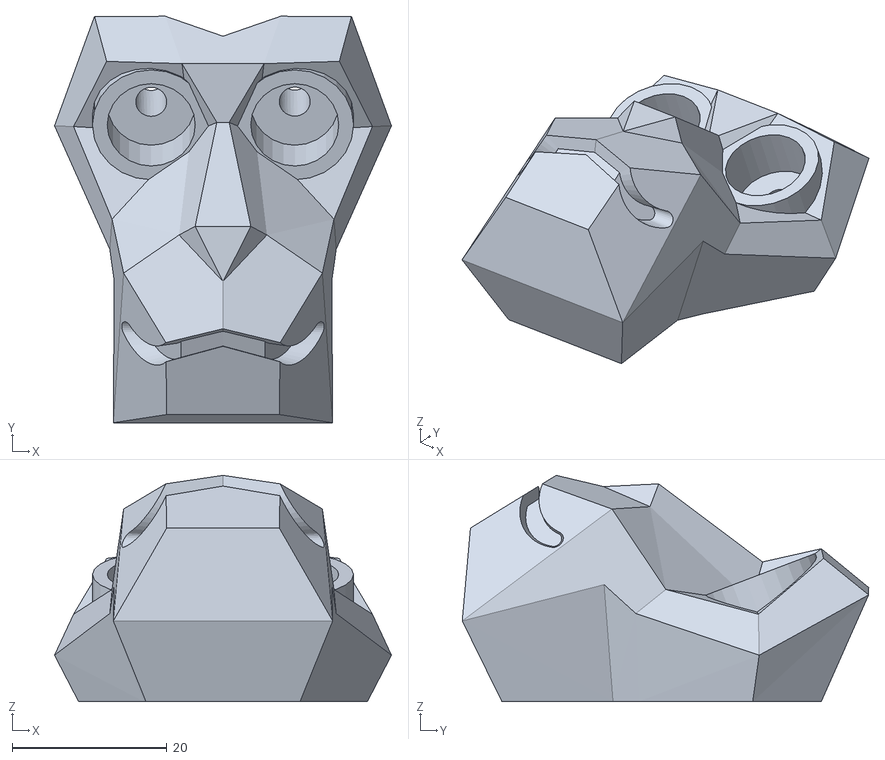
[picture p36: CAD file, 2025-09-03]
Models/STL Folder/Face.stl
43.5 x 52.5 x 29.2
