huonghuy/High-Altitude-Monkey/Models/STL Folder/right hand.stl

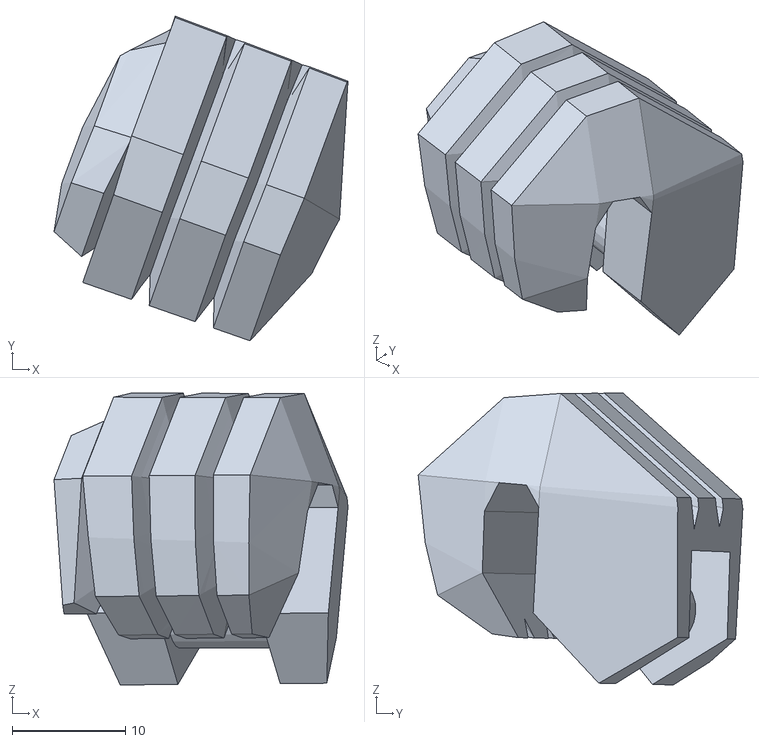
[picture p37: CAD file, 2025-09-03]
Models/STL Folder/right hand.stl
25.9 x 28.7 x 25.8
