huonghuy/High-Altitude-Monkey/Models/STL Folder/New Torso.3mf

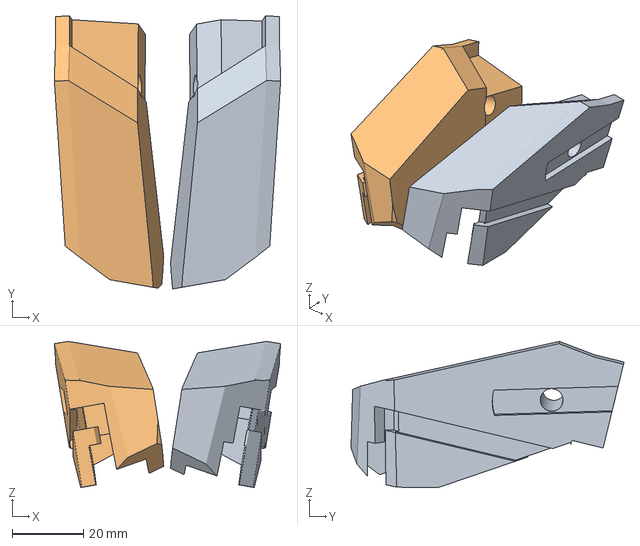
[picture p38: CAD file, 2025-09-03]
Models/STL Folder/New Torso.3mf
63.4 x 76.5 x 40.9 mm
Completed right-middle arm part 2 of 2.stl
Completed left arm part 2 of 2.stl
