huonghuy/High-Altitude-Monkey/Models/STL Folder/LEFT upper arm copy (1) (1) (1).stl

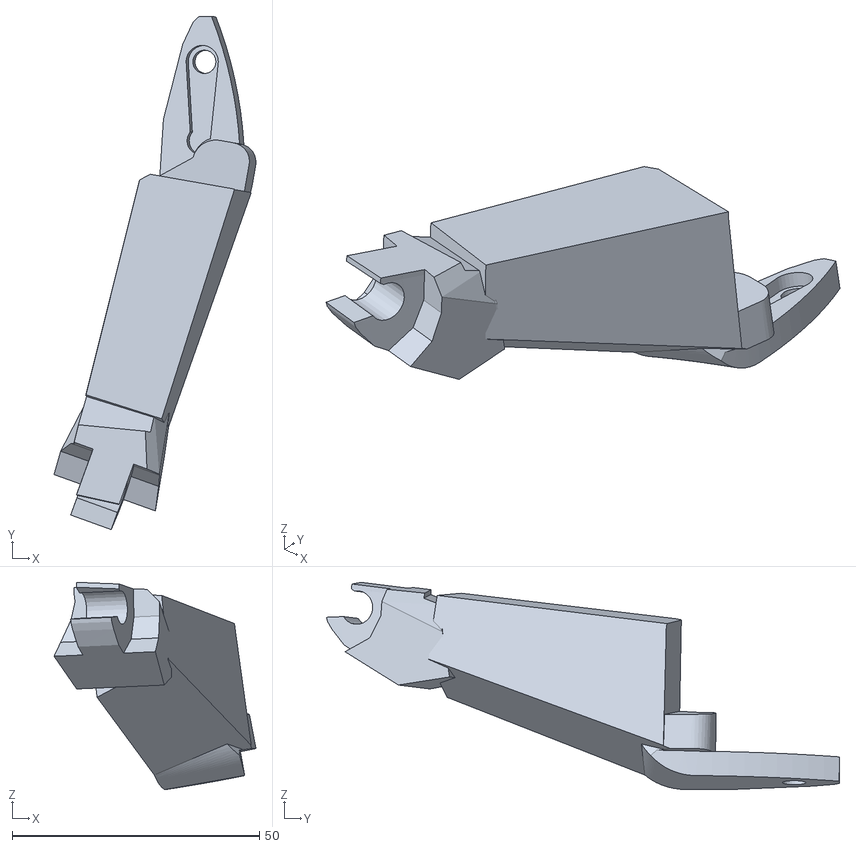
[picture p39: CAD file, 2025-09-03]
Models/STL Folder/LEFT upper arm copy (1) (1) (1).stl
40.9 x 103.9 x 42.0
