huonghuy/High-Altitude-Monkey/Models/STL Folder/hand.stl

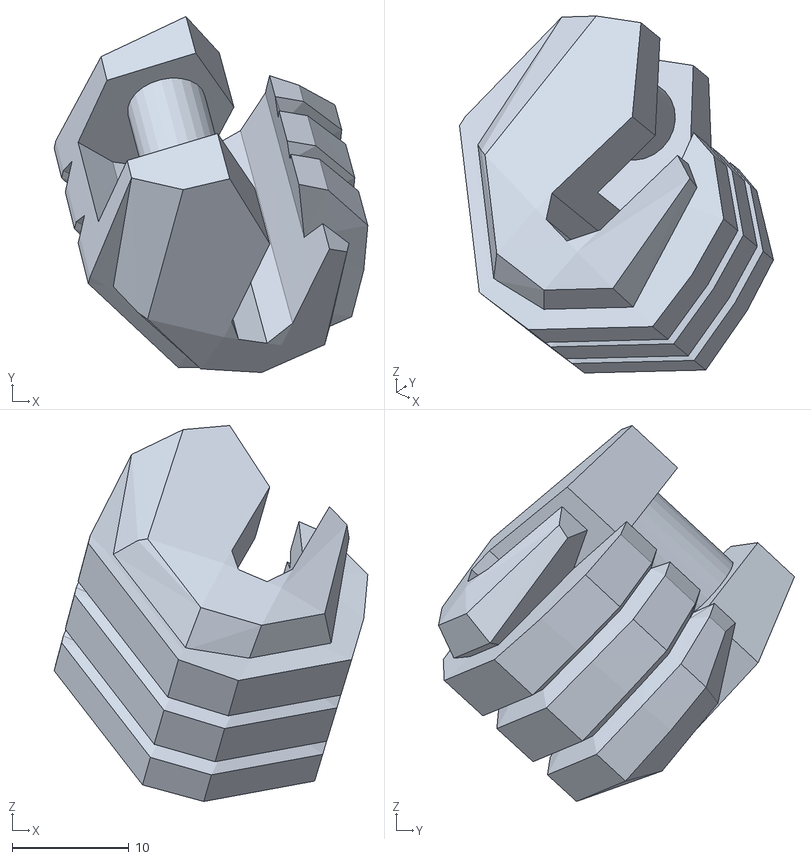
[picture p40: CAD file, 2025-09-03]
Models/STL Folder/hand.stl
26.9 x 30.5 x 32.2
