huonghuy/High-Altitude-Monkey/(list of files, cad)

Other CAD files:
Models/HAM Body.stl
Models/Output/HAM MC Output Panel.3mf
Models/Panel/HAM_MC_Plate.SLDPRT
Models/Panel/HAM MC Plate V0.7.SLDPRT
Models/Panel/HAM_MC_Plate-V0.6.3MF
Models/Panel/HAM_MC_Plate-V0.2.SLDPRT
Models/Panel/HAM PLate.SLDPRT
Models/Output/HAM MC Output Panel (1).3mf
Models/Panel/HAM_MC_Plate-V0.2.3MF
Models/Panel/HAM_MC_Plate-V0.4.3MF
Models/Panel/HAM_MC_Plate-V0.5.3MF
Models/Panel/HAM_MC_Plate.DXF
Models/STL Folder/New Torso.stl
