huonghuy/High-Altitude-Monkey/Backup Files/USIP/Final Assembly.docx

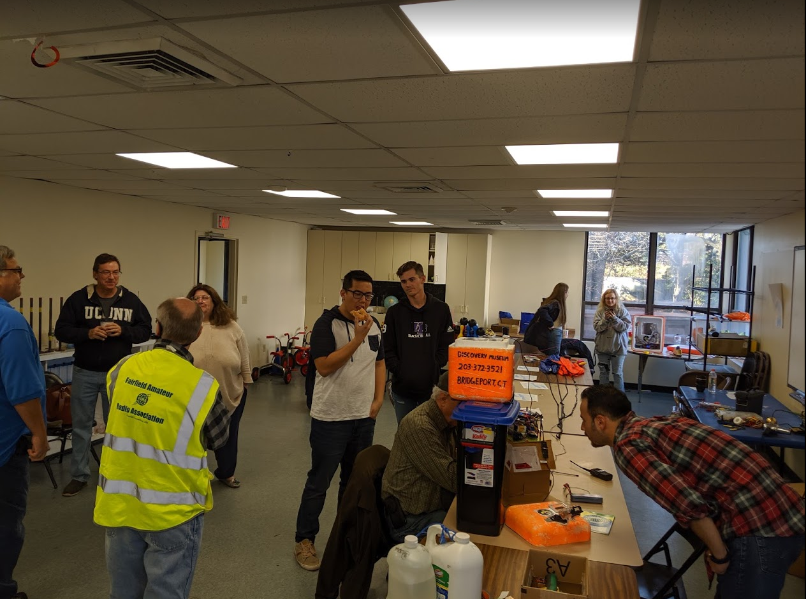
[picture p41: figure]
