huonghuy/High-Altitude-Monkey/OLD Random Gerbers/Gerber_HAM_MC/How-to-order-PCB.txt

How to Order PCB

Please refer to:
https://docs.easyeda.com/en/PCB/Order-PCB
