huonghuy/High-Altitude-Monkey/Backup Files/USIP/Documents/wiper write read test.odt

USIP Monkey 1.0MM

Found Pot

Stablizing Monkey

Just read character: 4D M

M

Just read character: 4F O

MO

Just read character: 4E N

MON

Just read character: 4B K

MONK

Just read character: 45 E

MONKE

Just read character: 59 Y

MONKEY

Just read character: 20

MONKEY

Just read character: 32 2

MONKEY 2

Just read character: 31 1

MONKEY 21

Just read character: A

MONKEY 21

Temp String is: MONKEY 21

It is this many characters long: 10

The substring is: MONKEY 21

MONKEY 21set MonkeyFlag = True

ENTERED MONKEY MOVE/video set AND MonkCMDStr is: MONKEY 21

calculating monkey video level number

setting monkey video level number to:

0

i = 21 wiper read value from pin = 167.00 Reading the wiperwiper read value from get.Wiper() = 21

i = 22 wiper read value from pin = 175.00 Reading the wiperwiper read value from get.Wiper() = 22

i = 23 wiper read value from pin = 183.00 Reading the wiperwiper read value from get.Wiper() = 23

i = 24 wiper read value from pin = 192.00 Reading the wiperwiper read value from get.Wiper() = 24

i = 25 wiper read value from pin = 200.00 Reading the wiperwiper read value from get.Wiper() = 25

i = 26 wiper read value from pin = 208.00 Reading the wiperwiper read value from get.Wiper() = 26

i = 27 wiper read value from pin = 216.00 Reading the wiperwiper read value from get.Wiper() = 27

i = 28 wiper read value from pin = 224.00 Reading the wiperwiper read value from get.Wiper() = 28

i = 29 wiper read value from pin = 232.00 Reading the wiperwiper read value from get.Wiper() = 29

i = 30 wiper read value from pin = 240.00 Reading the wiperwiper read value from get.Wiper() = 30

i = 31 wiper read value from pin = 248.00 Reading the wiperwiper read value from get.Wiper() = 31

i = 32 wiper read value from pin = 256.00 Reading the wiperwiper read value from get.Wiper() = 32

i = 33 wiper read value from pin = 264.00 Reading the wiperwiper read value from get.Wiper() = 33

i = 34 wiper read value from pin = 272.00 Reading the wiperwiper read value from get.Wiper() = 34

i = 35 wiper read value from pin = 280.00 Reading the wiperwiper read value from get.Wiper() = 35

i = 36 wiper read value from pin = 289.00 Reading the wiperwiper read value from get.Wiper() = 36

i = 37 wiper read value from pin = 297.00 Reading the wiperwiper read value from get.Wiper() = 37

i = 38 wiper read value from pin = 305.00 Reading the wiperwiper read value from get.Wiper() = 38

i = 39 wiper read value from pin = 313.00 Reading the wiperwiper read value from get.Wiper() = 39

i = 40 wiper read value from pin = 321.00 Reading the wiperwiper read value from get.Wiper() = 40

i = 41 wiper read value from pin = 329.00 Reading the wiperwiper read value from get.Wiper() = 41

i = 42 wiper read value from pin = 337.00 Reading the wiperwiper read value from get.Wiper() = 42

i = 43 wiper read value from pin = 346.00 Reading the wiperwiper read value from get.Wiper() = 43

i = 44 wiper read value from pin = 353.00 Reading the wiperwiper read value from get.Wiper() = 44

i = 45 wiper read value from pin = 361.00 Reading the wiperwiper read value from get.Wiper() = 45

i = 46 wiper read value from pin = 370.00 Reading the wiperwiper read value from get.Wiper() = 46

i = 47 wiper read value from pin = 378.00 Reading the wiperwiper read value from get.Wiper() = 47

i = 48 wiper read value from pin = 386.00 Reading the wiperwiper read value from get.Wiper() = 48

i = 49 wiper read value from pin = 394.00 Reading the wiperwiper read value from get.Wiper() = 49

i = 50 wiper read value from pin = 402.00 Reading the wiperwiper read value from get.Wiper() = 50

i = 51 wiper read value from pin = 410.00 Reading the wiperwiper read value from get.Wiper() = 51

i = 52 wiper read value from pin = 418.00 Reading the wiperwiper read value from get.Wiper() = 52

i = 53 wiper read value from pin = 426.00 Reading the wiperwiper read value from get.Wiper() = 53

i = 54 wiper read value from pin = 435.00 Reading the wiperwiper read value from get.Wiper() = 54

i = 55 wiper read value from pin = 442.00 Reading the wiperwiper read value from get.Wiper() = 55

i = 56 wiper read value from pin = 451.00 Reading the wiperwiper read value from get.Wiper() = 56

i = 57 wiper read value from pin = 459.00 Reading the wiperwiper read value from get.Wiper() = 57

i = 58 wiper read value from pin = 467.00 Reading the wiperwiper read value from get.Wiper() = 58

i = 59 wiper read value from pin = 475.00 Reading the wiperwiper read value from get.Wiper() = 59

i = 60 wiper read value from pin = 483.00 Reading the wiperwiper read value from get.Wiper() = 60

i = 61 wiper read value from pin = 491.00 Reading the wiperwiper read value from get.Wiper() = 61

i = 62 wiper read value from pin = 499.00 Reading the wiperwiper read value from get.Wiper() = 62

i = 63 wiper read value from pin = 507.00 Reading the wiperwiper read value from get.Wiper() = 63

i = 64 wiper read value from pin = 515.00 Reading the wiperwiper read value from get.Wiper() = 64

i = 65 wiper read value from pin = 524.00 Reading the wiperwiper read value from get.Wiper() = 65

i = 66 wiper read value from pin = 531.00 Reading the wiperwiper read value from get.Wiper() = 66

i = 67 wiper read value from pin = 539.00 Reading the wiperwiper read value from get.Wiper() = 67

i = 68 wiper read value from pin = 547.00 Reading the wiperwiper read value from get.Wiper() = 68

i = 69 wiper read value from pin = 555.00 Reading the wiperwiper read value from get.Wiper() = 69

i = 70 wiper read value from pin = 563.00 Reading the wiperwiper read value from get.Wiper() = 70

i = 71 wiper read value from pin = 572.00 Reading the wiperwiper read value from get.Wiper() = 71

i = 72 wiper read value from pin = 580.00 Reading the wiperwiper read value from get.Wiper() = 72

i = 73 wiper read value from pin = 588.00 Reading the wiperwiper read value from get.Wiper() = 73

i = 74 wiper read value from pin = 596.00 Reading the wiperwiper read value from get.Wiper() = 74

i = 75 wiper read value from pin = 604.00 Reading the wiperwiper read value from get.Wiper() = 75

i = 76 wiper read value from pin = 612.00 Reading the wiperwiper read value from get.Wiper() = 76

i = 77 wiper read value from pin = 620.00 Reading the wiperwiper read value from get.Wiper() = 77

i = 78 wiper read value from pin = 628.00 Reading the wiperwiper read value from get.Wiper() = 78

i = 79 wiper read value from pin = 636.00 Reading the wiperwiper read value from get.Wiper() = 79

i = 80 wiper read value from pin = 644.00 Reading the wiperwiper read value from get.Wiper() = 80

i = 81 wiper read value from pin = 653.00 Reading the wiperwiper read value from get.Wiper() = 81

i = 82 wiper read value from pin = 661.00 Reading the wiperwiper read value from get.Wiper() = 82

i = 83 wiper read value from pin = 669.00 Reading the wiperwiper read value from get.Wiper() = 83

set monkey video (done)MONKEY 11 (done) Signal
