huonghuy/High-Altitude-Monkey/Schematics/Schematic_HAM_2024-12-10.pdf

1098765432

## ADJ

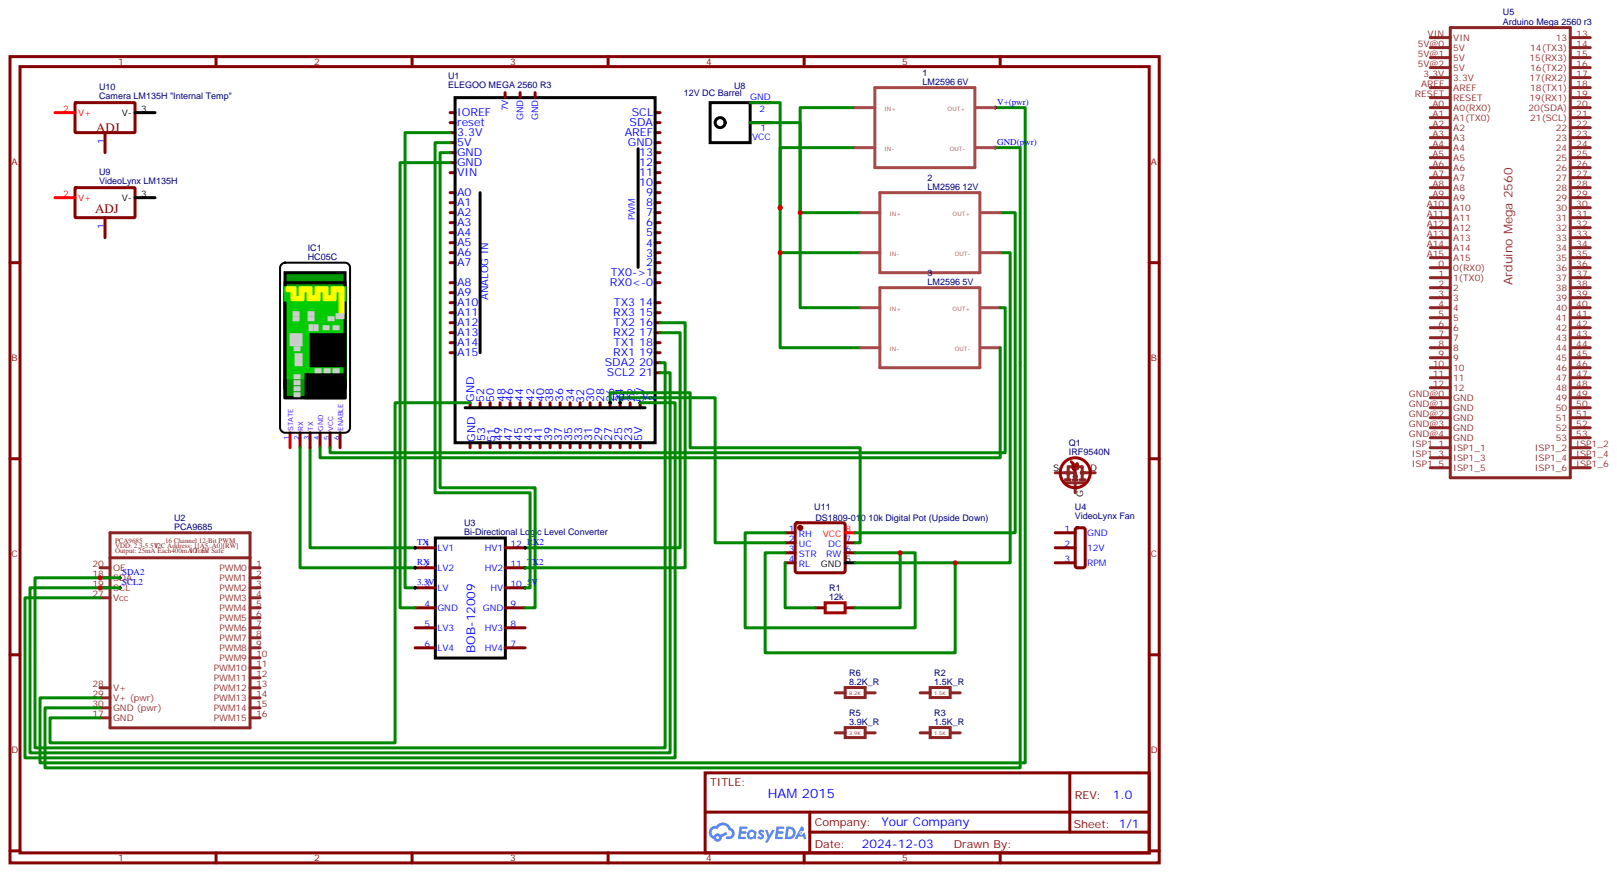
[picture p42: page 1]
