huonghuy/High-Altitude-Monkey/OLD Random Gerbers/HAM Breadboard.pdf

A

1 | 2 | 3 | 4 | 5 | 6

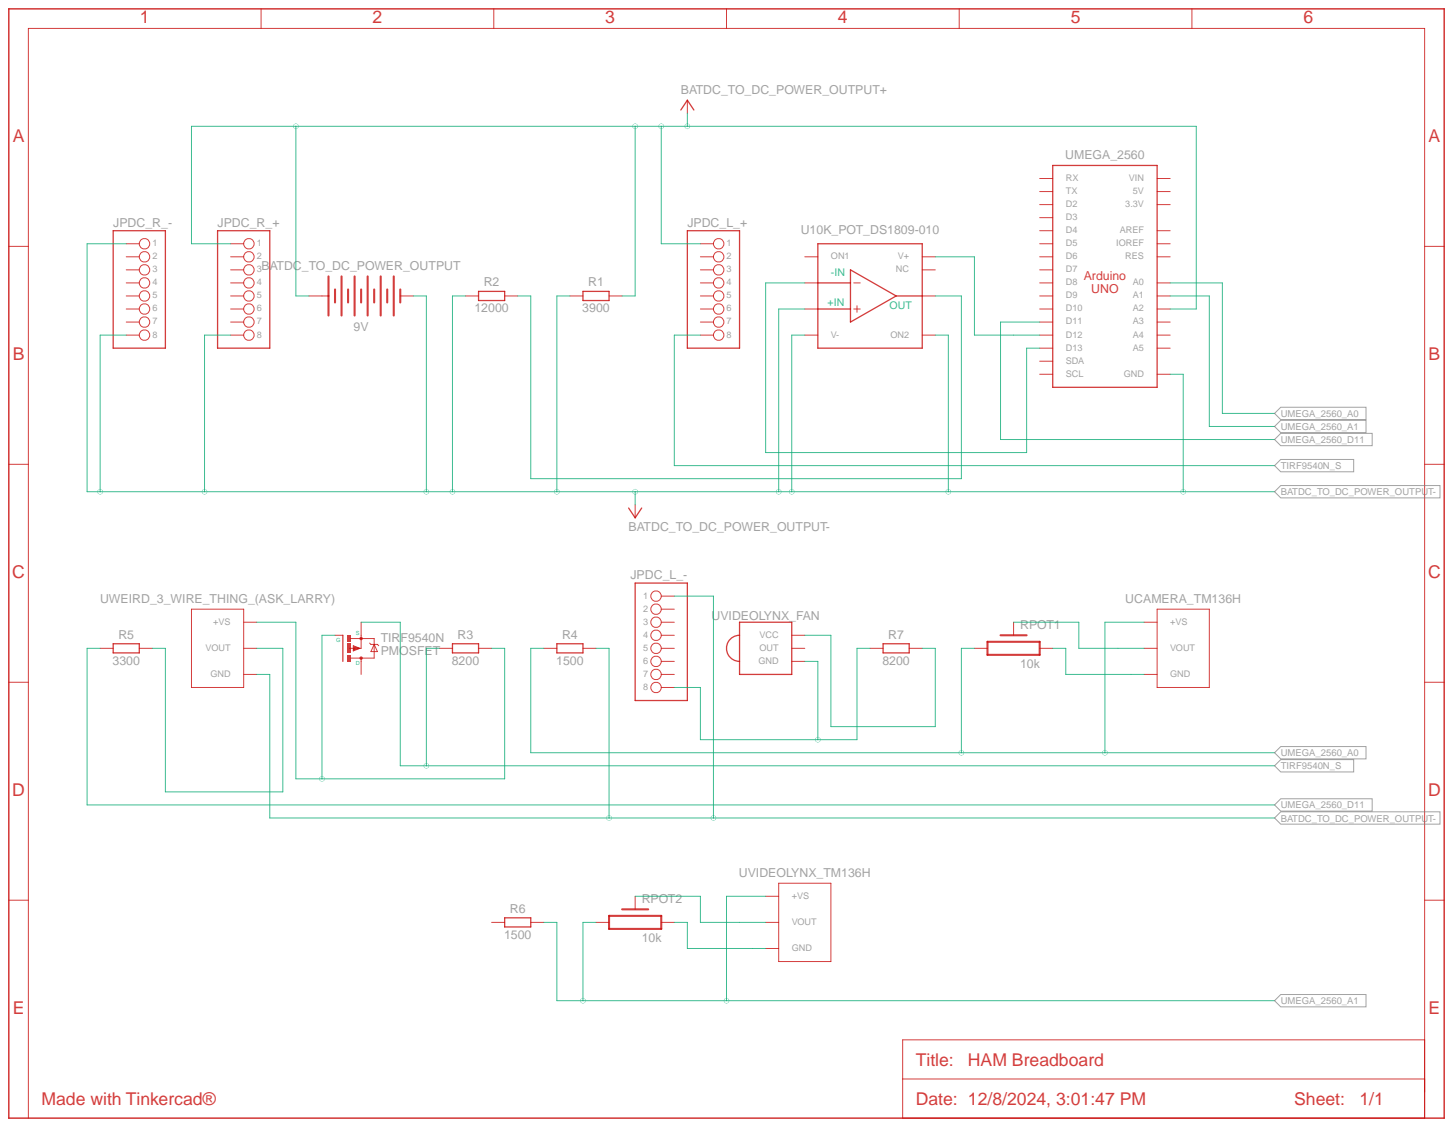
[picture p43: page 1]
