huonghuy/High-Altitude-Monkey/(list of files, drawings)

Other design files:
EasyEDA Schematics/HAM-LM_V2.7/PCB_HAM_Land_Module.json
EasyEDA Schematics/HAM-LM_V2.8/PCB_HAM_Land_Module.json
EasyEDA Schematics/HAM-Main_V2.7/PCB_HAM.json
EasyEDA Schematics/HAM-Main_V2.8/PCB_HAM.json
EasyEDA Schematics/HAM-MC_V2.5/PCB_HAM- Mission Control.json
EasyEDA Schematics/HAM-VL_V1.5/PCB_HAM-VideoLynx.json
EasyEDA Schematics/HC-05 Programmer_V0.2/PCB_HC-05 Programmer_V0.1.json
EasyEDA Schematics/uuidMap.json
EasyEDA Schematics/Version Control/Control/HAM-MC_V2.0/PCB_HAM- Mission Control.json
EasyEDA Schematics/Version Control/Control/HAM-MC_V2.4/PCB_HAM- Mission Control.json
EasyEDA Schematics/Version Control/Dead Bug/HAM-VL_V1.0/PCB_HAM-VideoLynx.json
EasyEDA Schematics/Version Control/Dead Bug/HAM-VL_V1.3/PCB_HAM-VideoLynx.json
EasyEDA Schematics/Version Control/Dead Bug/HAM-VL_V1.4/PCB_HAM-VideoLynx.json
EasyEDA Schematics/Version Control/Grey Box/HAM-LM_V2.0/PCB_HAM_Land_Module.json
EasyEDA Schematics/Version Control/Grey Box/HAM-LM_V2.6/PCB_HAM_Land_Module.json
EasyEDA Schematics/Version Control/HC-05 Programmer/HC-05 Programmer_V0.1/PCB_HC-05 Programmer_V0.1.json
EasyEDA Schematics/Version Control/Orange/HAM-Main_V2.6/PCB_HAM.json
EasyEDA Schematics/Version Control/Orange/HAM_V2.2/PCB_HAM.json
EasyEDA Schematics/Version Control/Orange/HAM_V2.5/PCB_HAM.json
OLD Random Gerbers/HAM V1.0/PCB_PCB_HAM-Mission-Control_2024-12-31.json
OLD Random Gerbers/HAM V1.0/PCB_PCB_HAM-VideoLynx_2024-12-31.json
OLD Random Gerbers/HAM V1.0/PCB_PCB_HAM_2024-12-31.json
OLD Random Gerbers/HAM V1.0/PCB_PCB_HAM_Land_Module_2024-12-31.json
OLD Random Gerbers/HAM V1.0/SCH_HAM-Land-Module_2024-12-31.json
OLD Random Gerbers/HAM V1.0/SCH_HAM-Mission-Control_2024-12-31.json
OLD Random Gerbers/HAM V1.0/SCH_HAM-VideoLynx_2024-12-31.json
OLD Random Gerbers/HAM V1.0/SCH_HAM_2024-12-31.json
