huonghuy/High-Altitude-Monkey/SRC/Monkey/USIP_Green_Monkey.h

  /* USIP Green Monkey header file. 
     This file contains the limits for the Green Monkey Servos
  */
 #ifndef _USIP_GRNMNKY_H
 #define _USIP_GRNMNKY_H
/////////// SOFTWARE VERSION NUMBER ///////////////////////////
// Ver 0.1M, 07/22/2023
// USIP Copyright 2023 University of Bridgeport, NASA, CT Space Grant Consortium.
// All rights reserved.
///////////////////////////////////////////////////////////////
#define VERSION "0.1GRNMNKY"
#define RT_ELBW_GO_HOME_PWM 200
#define RT_SHLDR_GO_HOME_PWM 275
#define LFT_SHLDR_GO_HOME_PWM 400


///////////////// HOME POSITIONS /////////////////////////////////
int botHead0 = 300;
int topHead1 = 350;
int rightShoulder2 = 275;
int rightElbow3 = 400;
int leftShoulder4 = 400;
int leftElbow5 = 100;

int elbowRange = 120;

int xv;
float wiper_read = 0.0;
uint8_t wiper_value = 0;
int i=0;
/////////////////////////////////////////////////////////////

#endif  /// _USIP_GRNMNKY_H
