huonghuy/High-Altitude-Monkey/(commit log)

2024-12-05 Collected all former USIP files, push to Github
    [USIP Monkey commands Excel.xlsx, USIP Monkey commands.ods]
2025-06-16 push to github
    [Drill_NPTH_Through.DRL, Drill_PTH_Through.DRL, Drill_PTH_Through_Via.DRL, Emic2.GBL, Emic2.GBO, Emic2.GBP, Emic2.GBS, Emic2.GTL]
2025-06-16 big push to github
    [USIP Monkey commands Excel.xlsx, USIP Monkey commands.ods]
2025-09-03 trying everything
    [Completed left arm part 2 of 2.stl, Completed right-middle arm part 2 of 2.stl, Face.stl, LEFT upper arm copy (1) (1) (1).stl, New Torso.3mf, New Torso.stl, PCB_HAM- Mission Control.json, PCB_HAM-VideoLynx.json]
