huonghuy/High-Altitude-Monkey/Posters-Presentations/ASEE - HARM Paper/Figures/Command_Processor.JPG

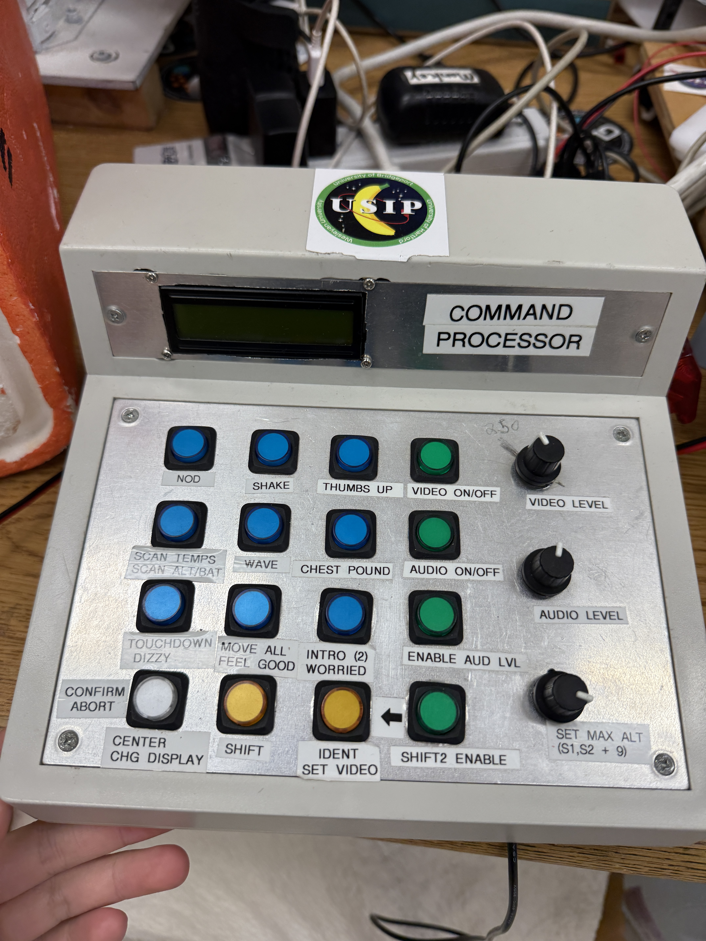
[picture p2: Posters-Presentations/ASEE - HARM Paper/Figures/Command_Processor.JPG]
Posters-Presentations/ASEE - HARM Paper/Figures/Command_Processor.JPG
